docteurzoidberg/raidmaster-403/README.md

# Raidmaster 403

Tripmaster GPS de rallye-raid fait maison pour une **Peugeot 403 break Familiale de 1961**, pensé pour le raid
**Crazy Dust 2027** et utilisable au quotidien en mode balade. Boîtier autonome aimanté sur la tôle du
tableau de bord : distances partielles A et B, odomètre, vitesse, cap, moyenne, chrono.

Site du projet : **<https://docteurzoidberg.github.io/raidmaster-403/>** (présentation, maquette 3D, simulateur
dans le navigateur, manuel d'utilisation en cours de rédaction).

<p align="center">
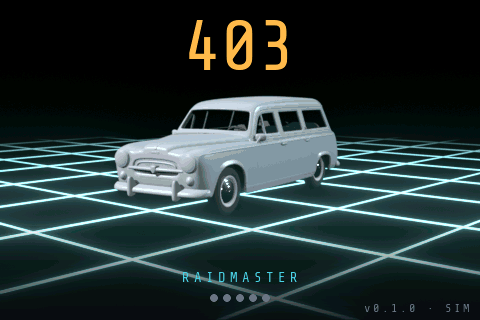
[picture p1: docs/demo/raidmaster-demo.gif]
Démo de l'interface dans le simulateur : démarrage animé, écran raid, balade, menu, calibration, mode nuit
  
</p>

<p align="center"><sub>Simulateur PC, échelle 1:1 de l'écran 480 × 320. GIF régénéré automatiquement à chaque build qui change l'interface.</sub></p>

## Matériel

| Élément | Choix |
|---|---|
| Carte | [Waveshare ESP32-S3-Touch-LCD-3.5B](https://www.waveshare.com/wiki/ESP32-S3-Touch-LCD-3.5B) : ESP32-S3, 8 Mo PSRAM, 16 Mo flash |
| Écran | 3,5" IPS 480 × 320, AXS15231B en QSPI, tactile capacitif intégré |
| GPS | au choix au montage : u-blox NEO-M9N sur la carte fille (UART, 10 Hz) + antenne active déportée sous le pare-brise, ou module externe NEO-M8N + boussole (« puck » de drone) posé sur le tableau de bord |
| Cap | magnétomètre QMC5883L (I²C) |
| Alimentation | batterie Li-ion interne gérée par l'AXP2101, recharge USB-C, aucun fil 12 V |
| Commandes | 5 boutons (A, B, menu, ▲ haut / +, ▼ bas / −) + tactile |
| Boîtier | PETG / ASA imprimé (pas de PLA : habitacle à 60 °C en été) ; fixation sur la tôle à définir (plus d'aimants noyés dans le boîtier ; des aimants rapportés au dos restent possibles) |

Distance **GPS uniquement**, sans capteur de roue ni intervention sur le câblage de la voiture.

## État

| Étape | Contenu | État |
|---|---|---|
| 1 | Squelette CMake + simulateur SDL 480 × 320 | fait |
| 2 | Core portable + tests : `gps_parser` (NMEA, sur minmea), `trip_engine` (distance, moyenne, chrono, calibration), `app` (boutons, menu, sauvegarde) | fait |
| 3 | Interface LVGL câblée sur le core : raid, balade, menu réglages actif, calibration auto, démarrage animé, mode nuit | fait |
| 4 | Simulateur : rejeu de traces NMEA, trajet simulé, scénarios de bout en bout | 23 scénarios en place (GPS, puck débranché, calibration de la boussole) ; simulateur web dans le navigateur (WebAssembly, maquette 3D et carte) ; inclinomètre et matériel à venir |
| 5-6 | HAL ESP32 et firmware sur la carte | en cours : firmware de démo validé sur la carte (écran, tactile, core et UI du sim, trajet GPS simulé, NVS, heure de la RTC, état USB / batterie), jingle de démarrage par le codec ES8311 (à écouter sur la carte) ; pilote du récepteur GPS réel écrit (NEO-M9N ou puck NEO-M8N sur UART : débit trouvé, modèle reconnu, réglé à 10 Hz) et de sa boussole (QMC5883L, IST8310, HMC5883L ou LIS3MDL sur I²C, cap dans le journal), à essayer sur la carte ; cap à l'écran, boutons, charge de la batterie à venir |
| 7-13 | Essai en modules, carte fille 4 couches (GPS, magnétomètre), boîtier aimanté, essai raid | à faire ; carte 3.5B reçue, datasheets et modèle 3D rassemblés ; PCB placé, non routé (version 1.1 : GPS interne ou puck externe) ; maquette 3D des cartes dans un boîtier de principe validée ([en ligne](https://docteurzoidberg.github.io/raidmaster-403/mockup/)) ; boîtier dessiné dans Fusion, STEP des pièces dans `enclosure/stepfiles/`, à éprouver |

Pas encore là : compensation d'inclinaison de la boussole, réglages de charge de la batterie (l'état
USB / batterie est lu, pas configuré), température réelle, log GPX.

## Maquette 3D

Les trois cartes (Waveshare, carte fille GPS et magnétomètre, carte boutons) dans leur boîtier (aspect
retenu : cannelures, pare-chocs en TPU, liseré et lettrage), assemblé ou éclaté, à faire tourner dans le navigateur : **<https://docteurzoidberg.github.io/raidmaster-403/mockup/>**. Sources de la page
dans [`web/mockup/`](web/mockup/) ; modèles 3D externes et fichiers STEP du boîtier dessiné dans Fusion (pièces
à éprouver) dans [`enclosure/`](enclosure/README.md).

<p align="center">
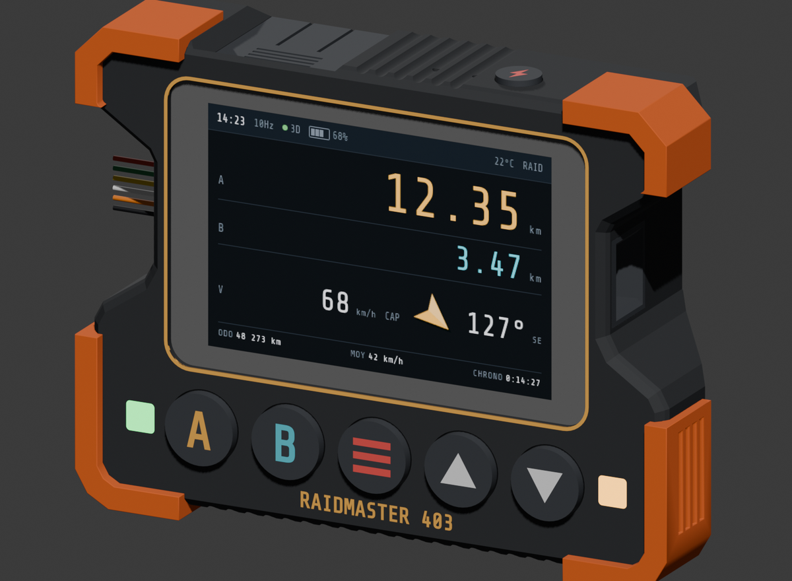
[picture p2: docs/demo/boitier-assemble.png]
Boîtier assemblé : écran 3,5 pouces, cinq boutons, deux voyants, pare-chocs en TPU orange aux coins
  
</p>
<p align="center">
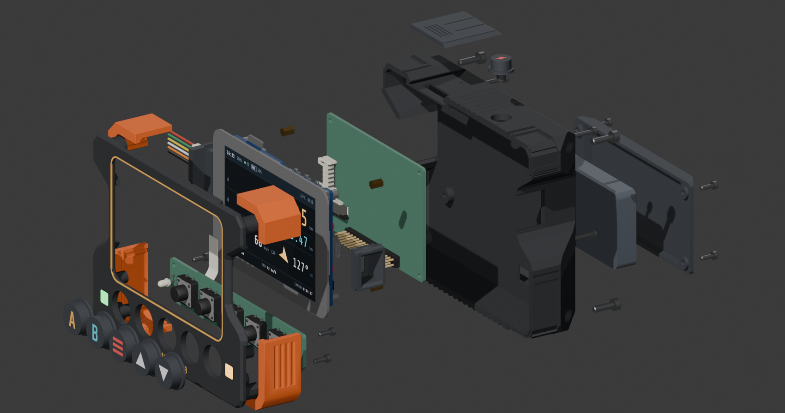
[picture p3: docs/demo/boitier-eclate.png]
Vue éclatée : capuchons, façade, pare-chocs en TPU, carte boutons et sa nappe, carte Waveshare, carte fille, fond du boîtier, batterie et sa trappe
  
</p>

<p align="center"><sub>Rendus Blender de la maquette : boîtier de 123 × 94 × 33 mm avec l'aspect retenu, esquisse du modèle dessiné pour l'impression.</sub></p>

## Simulateur dans le navigateur

Le firmware (mêmes `core/` et `ui/`, compilés en WebAssembly) tourne dans la maquette 3D : l'écran est
vivant, les cinq capuchons se cliquent (appui long en gardant le doigt 0,6 s), et une carte OpenStreetMap
suit le trajet GPS rejoué : **<https://docteurzoidberg.github.io/raidmaster-403/sim/>** (menu de toutes les
pages du site). Trajets : les scénarios des tests, ou un fichier NMEA à glisser sur la page
(il reste dans le navigateur) ; vitesse ×1 à ×1000 ; la case « Jouer les actions et les vérifications »
rejoue les appuis du scénario et affiche ses vérifications en vert ou rouge. Trips et réglages restent dans
le navigateur (bouton « Remise à zéro »). Son coupé par défaut (bouton « Son »). Mêmes touches que le
simulateur PC. Le tripmaster s'affiche de face (bouton « Recentrer » après une rotation) ; le bouton « Écran
seul » montre l'écran sur toute la largeur, avec une barre des cinq boutons dessous (`?vue=2d` l'ouvre
directement). Sur la carte, « Centrer » garde le véhicule au centre (un glisser le coupe).

Construit en local et commité dans `web/sim/` (publié avec le site). Prérequis :
[emsdk](https://emscripten.org/docs/getting_started/downloads.html) installé dans `~/sdk/emsdk` (ou
`EMSDK_DIR`), Node (celui d'emsdk suffit).

```bash
cd software
tools/web.sh             # build (build-web/), test sous Node, copie dans web/sim/
tools/web.sh serve       # sert le site web/ : http://localhost:8000/ (accueil), …/sim/
```

`tools/web.sh build`, `test` et `copy` font chaque étape seule. Le test joue les 23 scénarios dans le
module WebAssembly avec leurs vérifications, et compare une capture de l'écran à celle du simulateur PC
(identique au pixel près).

## Cartes électroniques

Deux circuits fabriqués d'un seul tenant puis séparés : la **carte fille** (78 × 54 mm, 4 couches), enfichée
au dos de la Waveshare, existe en deux variantes choisies au soudage : **GPS interne** (NEO-M9N, prise
d'antenne U.FL et boussole) ou **puck externe** (prise JST-PH 6 broches au bord gauche, protection et tampon
I²C pour le branchement à chaud) ; la **carte boutons**
(108 × 20 mm), vissée derrière la façade, porte les 5 poussoirs, les 2 voyants et deux expandeurs I²C, et
rejoint la carte fille par une nappe souple de 6 voies. Tout se soude au fer.

<p align="center">
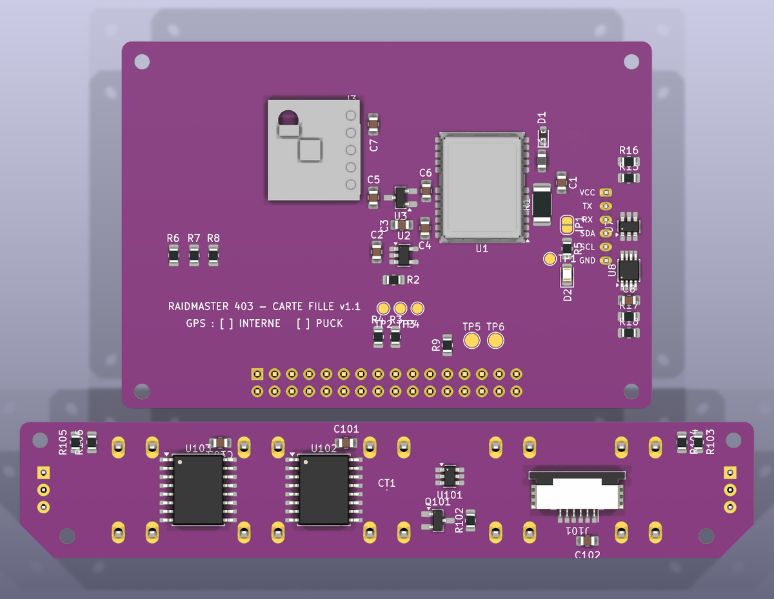
[picture p4: docs/demo/pcb-dessus.png]
Les deux cartes vues de dessus : GPS, boussole, régulateurs et protection de la prise du puck sur la carte fille ; expandeurs et connecteur de nappe au dos de la carte boutons
  
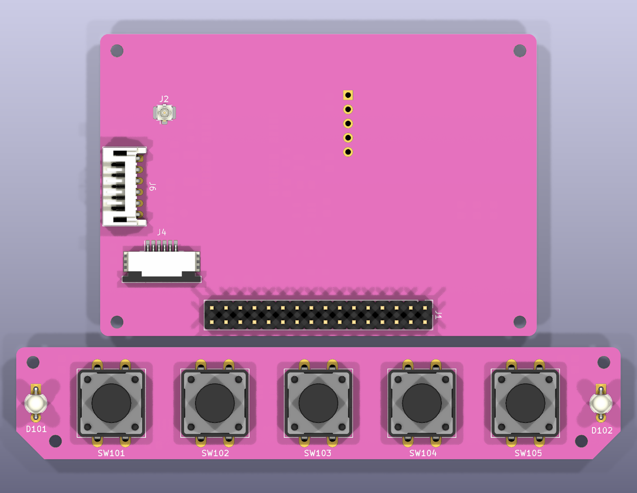
[picture p5: docs/demo/pcb-dessous.png]
Les deux cartes vues de dessous : connecteur 2 × 16 vers la Waveshare, connecteur de nappe, prise JST-PH du puck et prise d'antenne U.FL sur la carte fille ; poussoirs et voyants de la carte boutons
  
</p>

<p align="center"><sub>Rendus du visualiseur 3D de KiCad, dessus (côté batterie) et dessous (côté écran) : composants placés, routage à venir.</sub></p>

## Démarrage rapide (simulateur PC)

Prérequis : CMake ≥ 3.20, Ninja, un compilateur C11, SDL2 (`sudo apt install libsdl2-dev` sous
Debian / Ubuntu / WSL). LVGL, Unity et les autres dépendances sont téléchargées par CMake ou déjà dans le
dépôt. Le code est dans `software/` : les commandes se lancent depuis ce dossier.

```bash
cd software
cmake --preset sim
cmake --build build-sim
./build-sim/raidmaster-sim                                    # trajet simulé
./build-sim/raidmaster-sim --replay trace.nmea --speed 10     # rejoue un fichier NMEA ×10
```

Le core tourne comme sur la carte : GPS fourni par le simulateur (trajet simulé ou fichier rejoué),
réglages et distances sauvegardés dans `sim-storage.json`. Au lancement, le jingle de démarrage se joue
avec l'animation par la sortie audio SDL (WSLg sous WSL) ; `SDL_AUDIODRIVER=dummy` le coupe.

| Option | Effet |
|---|---|
| `--replay fichier.nmea` | rejoue un fichier au rythme de ses horodatages (sinon trajet simulé : boucle de 2 min) |
| `--speed N` | accélère le temps GPS, 1 à 1000 |
| `--loop` | rejoue le fichier en boucle |
| `--storage f.json` / `--no-storage` | fichier de sauvegarde (défaut `./sim-storage.json`) / en mémoire |
| `--script actions.txt --out dossier` | joue des actions horodatées en temps virtuel, sans attente (tests de bout en bout) |

| Touche | Bouton / action |
|---|---|
| `a` / `b` | A / B : RAZ Trip A / Trip B ; à la calibration auto : départ et arrivée (A), annuler (B) |
| `+` / `−` | ±10 m sur le trip actif ; dans le menu : monter / descendre, ou changer la valeur en édition |
| `m` | trip actif A ↔ B ; dans le menu : choisir / valider |
| `Maj` + touche | appui long : `Maj`+`m` entre dans le menu ou en sort, `Maj`+`+`/`−` ±100 m |
| `n` ou `Tab` | bascule jour / nuit |
| `d` | coupe / rétablit le signal GPS (tunnel) |
| `g` | débranche / rebranche le récepteur GPS (« GPS × », puis recherche du débit et réglage) |
| `c` | débranche / rebranche la boussole |
| `r` | la voiture tourne sur place / s'arrête (calibration de la boussole) |
| `p` | alimentation suivante (barre d'état) : batterie 68 %, USB en charge, USB batterie pleine, USB sans batterie, batterie 8 % |
| `v` | écran suivant (debug) |
| `Échap` | quitter (sauvegarde) |

### Tests

```bash
cd software
ctest --preset sim
tools/check.sh        # build + avertissements + tests + GIF + build firmware + simulateur web, résumé court
                      # (-c : tout recompiler, -s : sim seul, -w : sans le web)
```

- Tests unitaires du core avec [Unity](https://github.com/ThrowTheSwitch/Unity) : parseur NMEA, moteur
  de distance, application (boutons, menu, sauvegarde, source du cap), liaison avec le récepteur u-blox,
  boussole, synthétiseur et jingle de démarrage.
- Scénarios de bout en bout (`software/tests/fixtures/scenarios/`, 23 au catalogue) : le simulateur sans fenêtre
  rejoue une trace, appuie sur les boutons et vérifie l'état, en temps virtuel (une étape de 12 h se
  joue en moins d'une seconde, la suite entière en ~1,5 s). Les traces sont générées au build depuis
  l'itinéraire `route.txt` de chaque scénario (`software/tests/tools/gen_route.py`, Python sans dépendance).
- Les traces NMEA longues de `software/references/traces-brutes/` ne sont pas versionnées : présentes, elles sont
  rejouées (distances à ±0,1 % de la référence) ; absentes, ces tests sont ignorés.

### GIF de démo

`docs/demo/raidmaster-demo.gif` est régénéré par la cible CMake `demo_gif` à chaque build où le binaire du
simulateur change. Le simulateur tourne alors sans fenêtre, en temps virtuel, et enchaîne démarrage, raid,
balade, menu, calibration et raid de nuit. Le GIF se commite avec la modification d'interface qui l'a
produit.

- Désactiver : `cmake --preset sim -DRAIDMASTER_DEMO_GIF=OFF`.
- À la demande, agrandi ou vers un autre fichier : `software/tools/demo_gif.sh [-s 1..4] [-o sortie.gif]`.

### Animation de démarrage

La 403 fait un tour sur une grille cyan lumineuse, calé sur le jingle : elle s'élance sur les arpèges
puis ralentit en roue libre et s'arrête avec la fin de l'accord. L'animation est rendue dans **Blender**
(36 images en 480 × 320), puis convertie au build en `boot_anim.bin` (palette 256 couleurs) par
`ui/assets/boot_anim/build_boot_anim.py`. Deux formats, mêmes pixels, à trancher : **2** par défaut
(chaque image codée par différence avec la précédente, 0,95 Mo) ou **1** (images brutes, 5,5 Mo), choisi
par l'option CMake `RAIDMASTER_BOOT_ANIM_FORMAT`. Cette conversion demande Python avec Pillow et numpy,
désigné par la variable CMake `RAIDMASTER_PYTHON`.

La scène Blender et les images rendues ne sont pas publiées : elles reposent sur un modèle 3D de la 403
sous licence. Sans elles, ou sans Python, le build passe et l'écran de démarrage affiche une silhouette
fixe.

### Son

Le jingle de démarrage « Grille néon » (arpèges la m · fa · sol puis accord de La majeur, ~2,9 s) est
synthétisé à la volée par `core/synth.c` à partir d'une table de notes (`core/jingles.c`), en PCM 16 bits
mono à 22 050 Hz, sans fichier audio. Sortie SDL sur le sim, codec ES8311 et ampli NS4150B sur la carte
(volume dans `tools/fw.sh menuconfig`).

### Version

Le numéro de version est dans `software/VERSION` (seule source). L'écran de démarrage l'affiche avec la
plateforme : `v0.1.0 · SIM` sur le sim, `v0.1.0 · ESP32 · fe63e9e` sur la carte (hash git du firmware,
suivi de `*` s'il a été compilé avec des modifications non commitées). ESP-IDF reprend le même numéro.

### Polices

Tout l'affichage est en **Share Tech Mono**, compilée en polices bitmap LVGL, uniquement pour les tailles
et les glyphes utilisés. Les mêmes fichiers servent au simulateur et à l'ESP32. Régénération :
`ui/fonts/gen_fonts.sh` (demande Node.js, appelle `lv_font_conv`).

## Participer au projet : partir de zéro

Le développement se fait sur PC, sans la carte : simulateur et tests suffisent jusqu'à l'étape 5.
Testé sous Ubuntu 24.04 (natif ou WSL2).

1. **Outils système**

   ```bash
   sudo apt install build-essential cmake ninja-build git pkg-config libsdl2-dev python3-venv
   ```

   CMake ≥ 3.20. Sous WSL2, la fenêtre SDL s'affiche via WSLg (Windows 11).

2. **Cloner**

   ```bash
   git clone git@github.com:docteurzoidberg/raidmaster-403.git
   cd raidmaster-403
   ```

3. **Python + Pillow + numpy** (optionnel, pour l'animation de démarrage)

   ```bash
   python3 -m venv .venv
   .venv/bin/pip install pillow numpy
   ```

   CMake prend `.venv/` à la racine du dépôt (à côté de `software/`) s'il existe, sinon le `python3` du système. Pour en
   imposer un autre : `-DRAIDMASTER_PYTHON=/chemin/vers/python`. Sans Pillow ou numpy, le build passe
   quand même : le démarrage affiche une silhouette fixe.

4. **Configurer, compiler, tester, lancer**

   ```bash
   cd software
   cmake --preset sim          # télécharge LVGL et Unity au premier passage (connexion requise)
   cmake --build build-sim
   ctest --preset sim
   ./build-sim/raidmaster-sim
   ```

   Le build régénère aussi `docs/demo/raidmaster-demo.gif`. Si tu ne touches pas à l'interface et que
   `git status` le montre modifié, annule-le (`git checkout docs/demo/raidmaster-demo.gif`) ou configure
   avec `-DRAIDMASTER_DEMO_GIF=OFF`.

5. **Traces NMEA de test** (optionnel). `software/references/` n'est pas versionné. Les traces longues se
   génèrent avec les scripts Python de `software/tests/tools/` (sans dépendance, voir `software/tests/tools/README.md`),
   par exemple :

   ```bash
   mkdir -p software/references/traces-brutes
   python3 software/tests/tools/gen_nmea.py --mode linear --duration 3600 --rate 10 --speed-kmh 90 \
       --heading-deg 90 --start-lat 48.8566 --start-lon 2.3522 --start-utc 2026-10-09T06:00:00+00:00 \
       --out software/references/traces-brutes/stage_highway_1h.nmea
   ```

   Sans elles, les tests qui les rejouent sont ignorés. Si les paramètres diffèrent de ceux de
   référence, ces tests peuvent échouer sur les comptes attendus.

6. **Avant de proposer une modification**
   - Pour un changement important, ouvrir d'abord une issue pour en discuter.
   - C11 strict, compilation sans avertissement (`-Wall -Wextra -Wpedantic`), `core/` sans aucun
     accès matériel ni LVGL.
   - Une branche par sujet, `software/tools/check.sh` propre (aucun avertissement, tests verts), GIF de démo commité avec toute modification de
     l'interface, ce README mis à jour s'il devient faux.
   - Optionnel : `compile_commands.json` est exporté dans `software/build-sim/` pour clangd ou ton IDE (lien
     symbolique à la racine si besoin).
   - Code sous GPL-3.0.

## Firmware ESP32

Projet ESP-IDF dans `software/firmware/`, construit avec **ESP-IDF v5.5.6** et les **mêmes** `core/` et
`ui/` que le simulateur (leurs `CMakeLists.txt` servent aux deux builds) ; les pilotes de la carte sont
dans `software/hal_esp32/`. Version actuelle : **démo** sans périphérique externe (trajet GPS simulé,
tactile en guise de boutons, sauvegarde en NVS, animation de démarrage en flash, jingle de démarrage par
le codec ES8311, heure de la RTC, état USB / batterie lu sur le PMIC).

```bash
cd software
tools/fw.sh build        # compile (ESP-IDF chargé par le script)
tools/fw.sh flash        # programme + animation de démarrage, puis 10 s de journal de la carte
tools/fw.sh log 20       # redémarre la carte et affiche 20 s de journal
tools/fw.sh menuconfig   # menu « Raidmaster 403 » : sens de l'écran, rétroéclairage, volume, tactile-boutons, source GPS, boussole
```

Installation d'ESP-IDF, liaison de la carte à WSL (usbipd), réglages et dépannage :
[`software/firmware/README.md`](software/firmware/README.md).

## Organisation du dépôt

```
software/        tout le code ; CMakeLists.txt et CMakePresets.json, build dans software/build-sim/ ;
                 VERSION : numéro de version
  core/          logique métier en C11 portable (aucun accès matériel) : gps_parser, trip_engine, app,
                 gps_synth (trajet simulé), ubx et gps_link (liaison avec un récepteur u-blox), mag (boussole),
                 synth et jingles (son) ; core/include/hal/ : interfaces matériel ;
                 core/third_party/minmea
  ui/            interface LVGL v9 : écrans, thème jour / nuit, polices, images, animation de démarrage
  sim/           simulateur PC SDL2 : fenêtre, clavier, options, mode script (script.c), captures, GIF
  hal_sim/       HAL du simulateur : GPS (rejeu, trajet simulé), stockage JSON, horloge, assets, son SDL
  simweb/        simulateur web (WebAssembly) : front-end, index des scénarios, test Node (tests/)
  hal_simweb/    HAL du simulateur web : stockage du navigateur, son Web Audio (le reste vient de hal_sim/)
  hal_esp32/     HAL et pilotes de la carte (écran QSPI, tactile, RTC, PMIC, son ES8311, NVS, GPS de démo ou réel…),
                 composant ESP-IDF
  firmware/      projet ESP-IDF (main/, sdkconfig.defaults, partitions.csv), build dans software/build-firmware/
  cmake/         modules CMake communs au sim et au firmware (animation de démarrage, version)
  tests/         tests unitaires Unity, scénarios (fixtures/scenarios/), tools/ : outils Python NMEA
  tools/         scripts : check.sh (vérification complète), fw.sh (firmware), web.sh (simulateur web), demo_gif.sh
  references/    non versionné : traces NMEA de test
hardware/kicad/carte-fille/
                 projet KiCad 10 de la carte fille et de la carte boutons (schémas, PCB, bibliothèques,
                 3d/ : modèles 3D propres et leur provenance, export/ : STEP des deux cartes)
hardware/kicad/BOM.md
                 composants des deux cartes : version GPS intégré et version puck GPS externe
enclosure/       boîtier : modèles 3D externes utilisés (README.md), stepfiles/ : exports STEP des pièces du boîtier
web/             site publié sur GitHub Pages : accueil (index.html), common/ : en-tête et styles communs,
                 mockup/ : maquette 3D des cartes dans leur boîtier (page three.js et modèle GLB),
                 sim/ : simulateur web (page, module construit par tools/web.sh, scénarios),
                 manual/ : manuel d'utilisation (en cours de rédaction), img/ : images de l'accueil
.github/         workflow de publication de web/ sur GitHub Pages
docs/demo/       GIF de démo, rendus des cartes (KiCad) et du boîtier (Blender)
```

## Documentation

- [`software/firmware/README.md`](software/firmware/README.md) : installation d'ESP-IDF, liaison de la
  carte, réglages et dépannage du firmware.
- [`software/tests/tools/README.md`](software/tests/tools/README.md) : outils NMEA (génération, bruit,
  validation, enregistrement).
- [`software/tests/fixtures/scenarios/README.md`](software/tests/fixtures/scenarios/README.md) : catalogue
  des scénarios de bout en bout.
- [`enclosure/README.md`](enclosure/README.md) : modèles 3D externes et fichiers STEP du boîtier.
- [`web/README.md`](web/README.md) : le site ([en ligne](https://docteurzoidberg.github.io/raidmaster-403/)) :
  accueil, maquette 3D, simulateur web, manuel.

## Licence

[GPL-3.0](LICENSE).

Composants tiers :

| Composant | Licence | Usage |
|---|---|---|
| [LVGL](https://lvgl.io) v9.2.2 | MIT | interface, téléchargé au build (FetchContent pour le sim, registre ESP-IDF pour le firmware) |
| [ESP-IDF](https://github.com/espressif/esp-idf) v5.5.6 | Apache-2.0 | framework du firmware, installé à part |
| [esp_lcd_axs15231b](https://components.espressif.com/components/espressif/esp_lcd_axs15231b) 1.0.1, [esp_io_expander_tca9554](https://components.espressif.com/components/espressif/esp_io_expander_tca9554) 2.0.3 | Apache-2.0 | pilotes d'écran et d'expandeur, téléchargés au build |
| [esp_codec_dev](https://components.espressif.com/components/espressif/esp_codec_dev) 1.3.4 | Apache-2.0 | pilote du codec audio ES8311, téléchargé au build |
| Séquence d'init du panneau ([exemples Waveshare](https://github.com/waveshareteam/ESP32-S3-Touch-LCD-3.5B)) | Apache-2.0 | dans `hal_esp32/board_display.c` |
| [minmea](https://github.com/kosma/minmea) | MIT (au choix WTFPL / MIT / LGPL-3) | décodage NMEA, dans `core/third_party/minmea/` |
| [Unity](https://github.com/ThrowTheSwitch/Unity) v2.6.1 | MIT | tests, téléchargé au build |
| [Share Tech Mono](https://fonts.google.com/specimen/Share+Tech+Mono) | SIL OFL 1.1 | police, dans `ui/assets/` |
| [three.js](https://threejs.org) 0.186.1 | MIT | maquette 3D et simulateur web (`web/`), chargé depuis jsDelivr |
| [Leaflet](https://leafletjs.com) 1.9.4 | BSD-2-Clause | carte du simulateur web (`web/sim/`), chargé depuis jsDelivr |
| Tuiles [OpenStreetMap](https://www.openstreetmap.org/copyright) | données ODbL, attribution affichée | fond de carte du simulateur web, usage léger ([politique des tuiles](https://operations.osmfoundation.org/policies/tiles/)) |
| [Emscripten](https://emscripten.org) | MIT / University of Illinois NCSA | compilateur du simulateur web, installé à part ; son code d'exécution est dans le module construit |
