docteurzoidberg/raidmaster-403/enclosure/stepfiles/README.md

# Fichiers STEP du boîtier

Exports STEP des pièces du boîtier du Raidmaster 403, depuis le modèle Fusion. Toutes les pièces sont dans le
même repère et s'assemblent sans déplacement.

La liste des fichiers et leur contenu sont dans [`../README.md`](../README.md) (section « Fichiers STEP du
projet »).
