docteurzoidberg/raidmaster-403/enclosure/stepfiles/manchon_bouchon.step

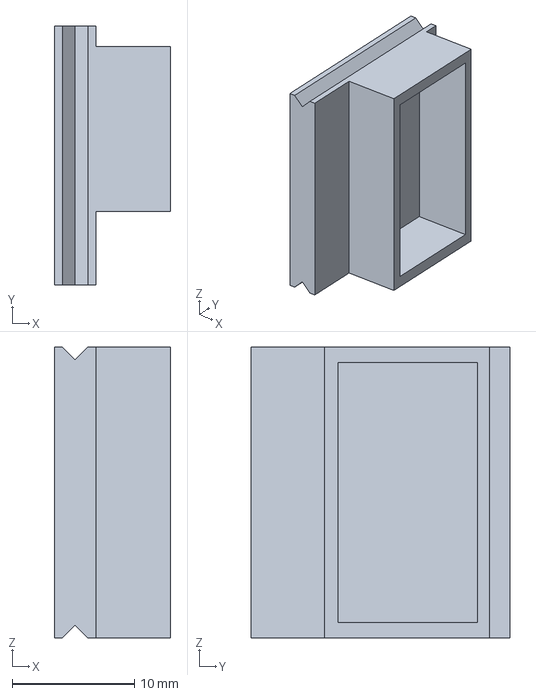
[picture p6: CAD file, 2026-11-14]
enclosure/stepfiles/manchon_bouchon.step
9.50 x 21.1 x 23.8 mm
