docteurzoidberg/raidmaster-403/hardware/kicad/carte-fille/3d/GY-271_module.step

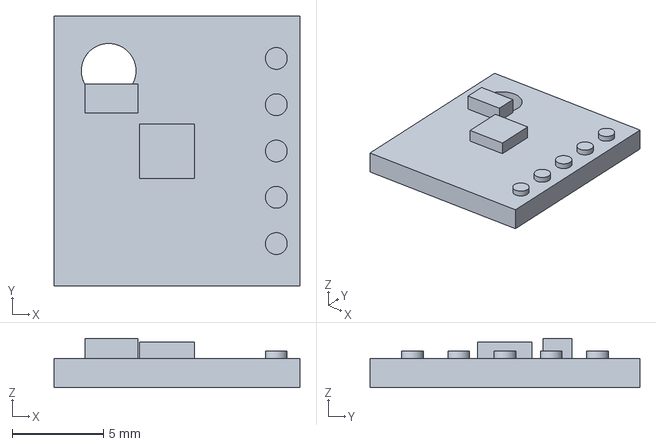
[picture p7: CAD file, 2026-11-11]
hardware/kicad/carte-fille/3d/GY-271_module.step
13.5 x 14.8 x 2.70 mm
