docteurzoidberg/raidmaster-403/hardware/kicad/carte-fille/export/carte-boutons.step

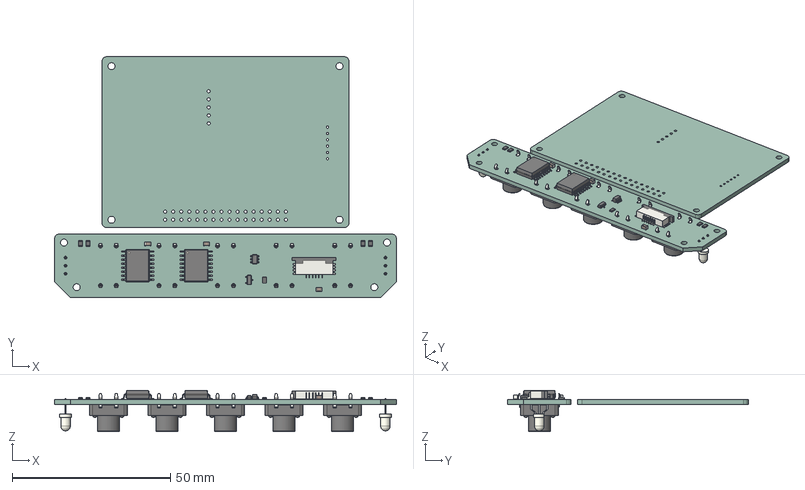
[picture p8: CAD file, 2026-11-12]
hardware/kicad/carte-fille/export/carte-boutons.step
108.0 x 76.0 x 13.0 mm
SOIC-16W_7.5x10.3mm_P1.27mm x 2
TE_84952_6
C_0805_2012Metric x 3
R_0805_2012Metric x 5
SOT-23
SOT-23-6
LED_D3.0mm-3 x 2
SW_PUSH-12mm_Wuerth-430476085716 x 5
carte-fille_PCB_1
carte-fille_PCB_2
