docteurzoidberg/raidmaster-403/enclosure/stepfiles/coque_arriere.step

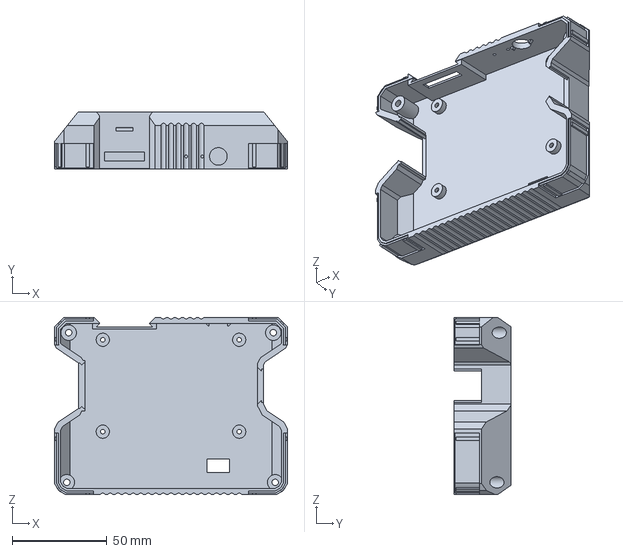
[picture p9: CAD file, 2026-11-14]
enclosure/stepfiles/coque_arriere.step
123.0 x 30.2 x 93.6 mm
