docteurzoidberg/raidmaster-403/hardware/kicad/carte-fille/3d/ublox_NEO.step

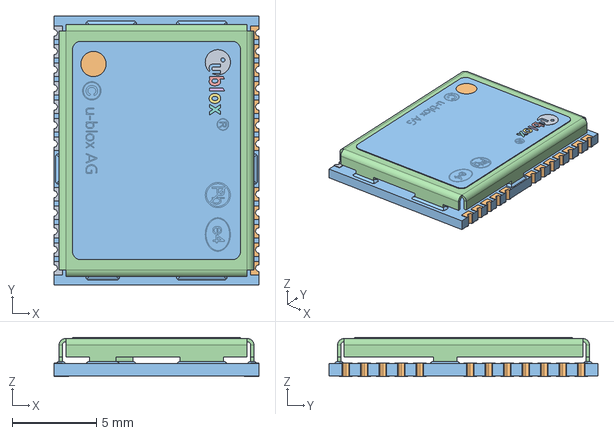
[picture p10: CAD file, 2026-10-24]
hardware/kicad/carte-fille/3d/ublox_NEO.step
12.2 x 16.0 x 2.33 mm
