docteurzoidberg/raidmaster-403/enclosure/stepfiles/facade.step

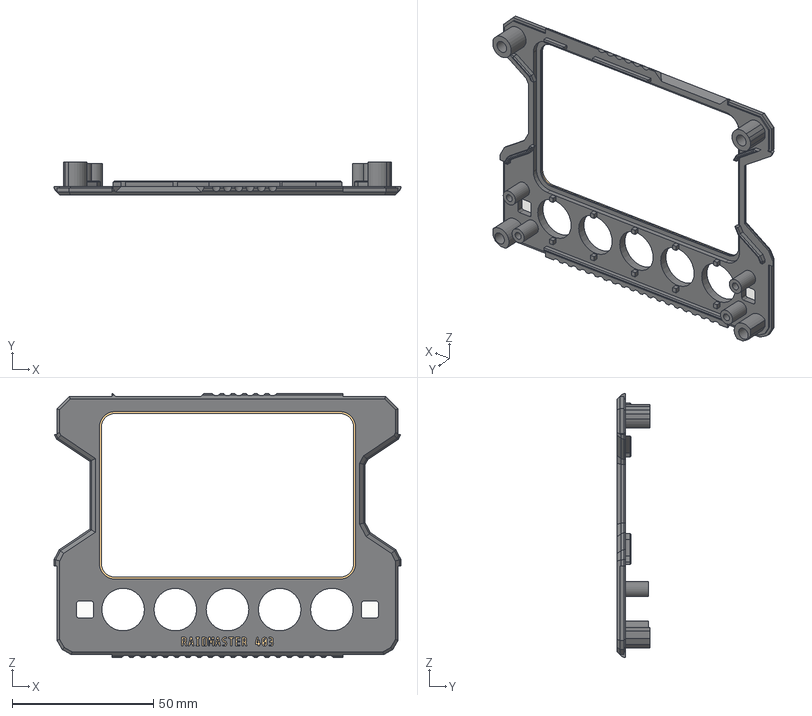
[picture p11: CAD file, 2026-11-14]
enclosure/stepfiles/facade.step
123.0 x 11.6 x 93.6 mm
