docteurzoidberg/raidmaster-403/enclosure/stepfiles/manchon_puck.step

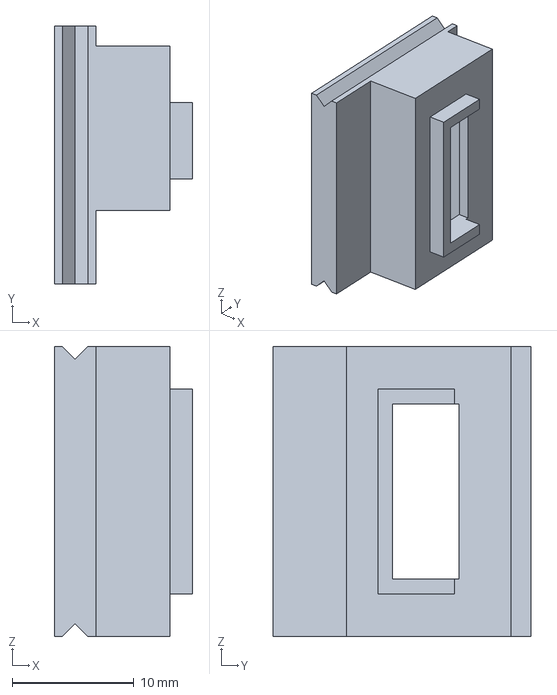
[picture p12: CAD file, 2026-11-14]
enclosure/stepfiles/manchon_puck.step
11.3 x 21.1 x 23.8 mm
