docteurzoidberg/raidmaster-403/enclosure/stepfiles/manchon_usb.step

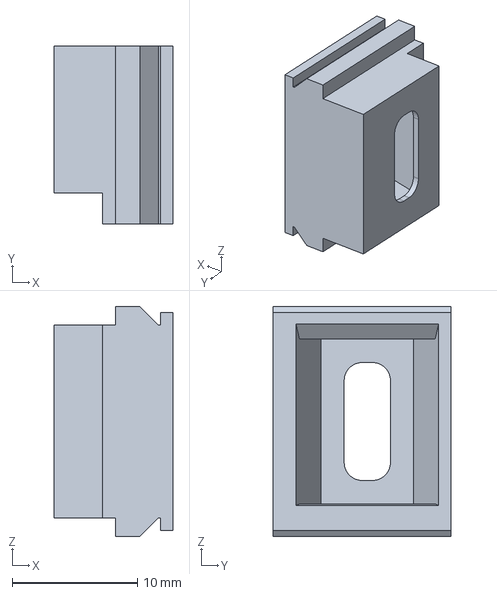
[picture p13: CAD file, 2026-11-14]
enclosure/stepfiles/manchon_usb.step
9.50 x 14.2 x 18.4 mm
