docteurzoidberg/raidmaster-403/enclosure/stepfiles/poussoir_pwr.step

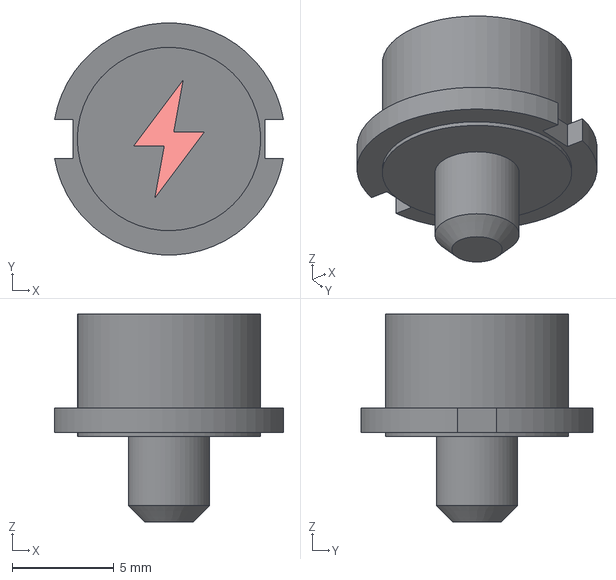
[picture p14: CAD file, 2026-11-14]
enclosure/stepfiles/poussoir_pwr.step
11.2 x 11.4 x 10.2 mm
