docteurzoidberg/raidmaster-403/enclosure/stepfiles/capuchon_bas.step

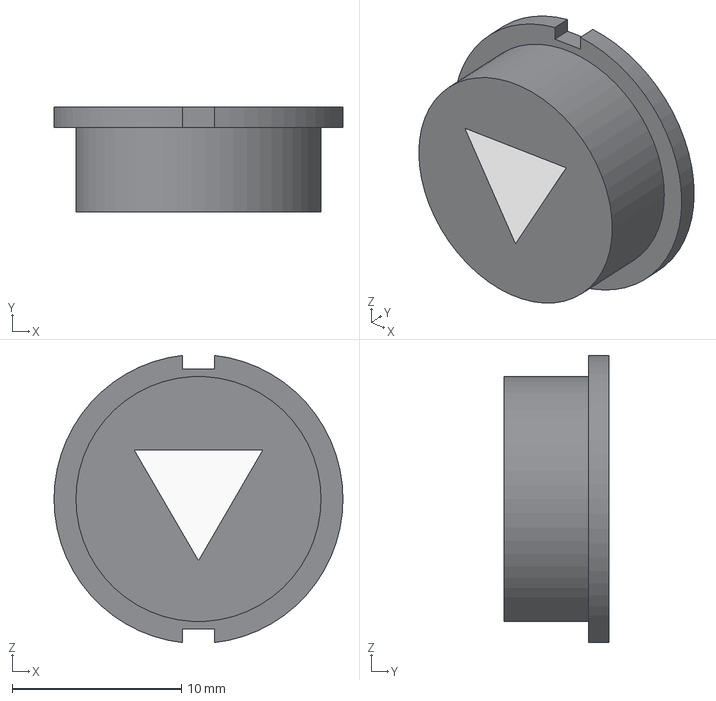
[picture p16: CAD file, 2026-11-13]
enclosure/stepfiles/capuchon_bas.step
17.1 x 6.20 x 17.0 mm
