docteurzoidberg/raidmaster-403/enclosure/stepfiles/pare_chocs.step

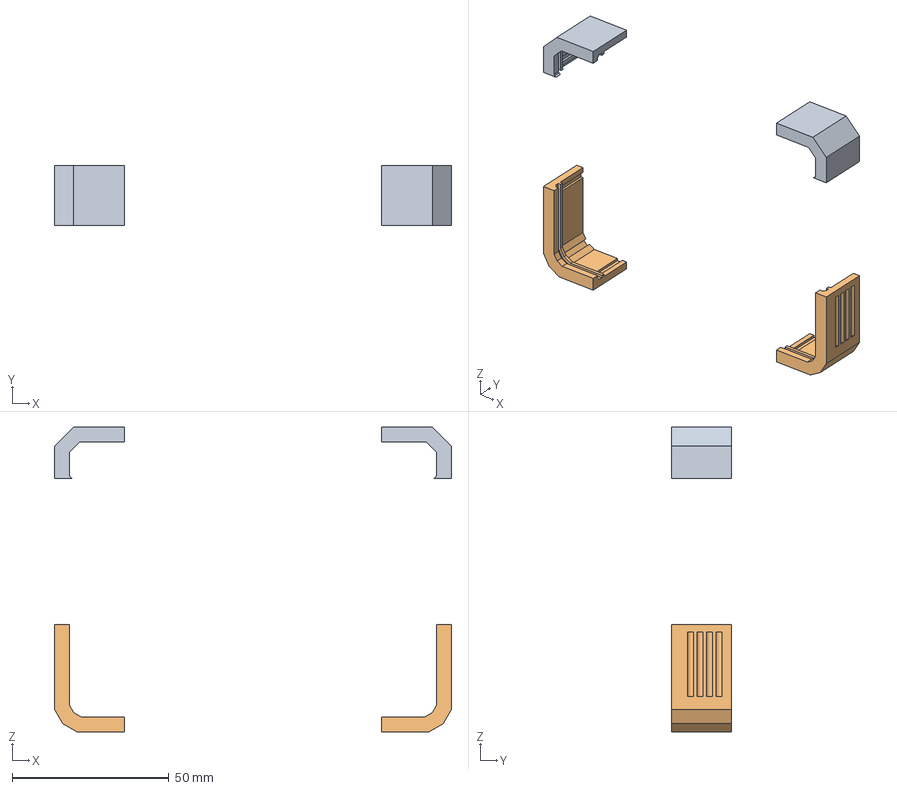
[picture p18: CAD file, 2026-11-13]
enclosure/stepfiles/pare_chocs.step
126.6 x 19.1 x 97.2 mm
