docteurzoidberg/raidmaster-403/enclosure/stepfiles/trappe_batterie.step

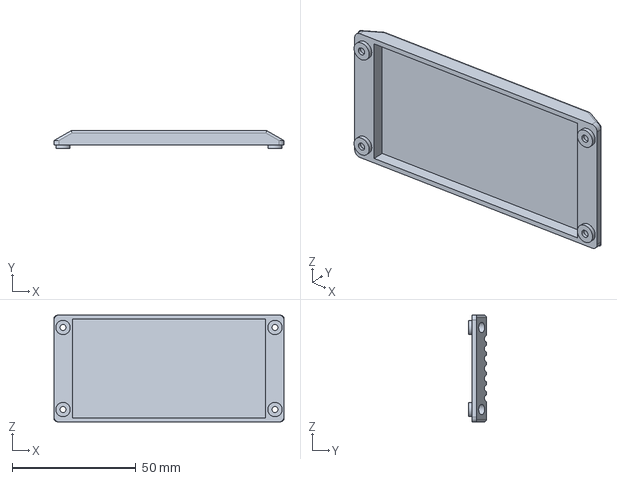
[picture p19: CAD file, 2026-11-13]
enclosure/stepfiles/trappe_batterie.step
93.0 x 7.20 x 43.2 mm
