docteurzoidberg/raidmaster-403/enclosure/stepfiles/trappe_sd.step

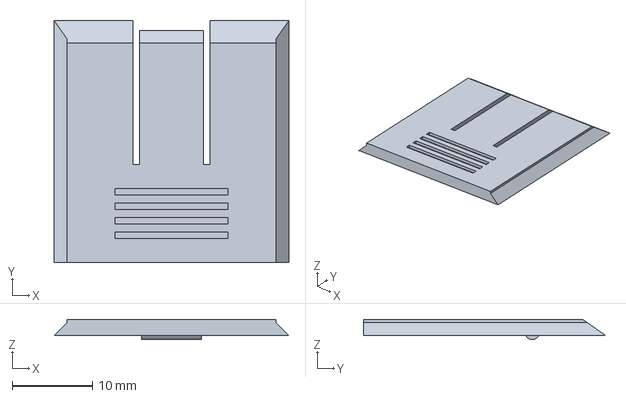
[picture p20: CAD file, 2026-11-12]
enclosure/stepfiles/trappe_sd.step
29.2 x 30.1 x 2.50 mm
