docteurzoidberg/raidmaster-403/(list of files, cad)

Other CAD files:
hardware/kicad/carte-fille/export/carte-fille.step
enclosure/stepfiles/manchon_antenne.step
enclosure/stepfiles/capuchon_haut.step
enclosure/stepfiles/capuchon_A.step
