docteurzoidberg/raidmaster-403/hardware/kicad/carte-fille/carte-fille.kicad_pcb

## KiCad design hardware/kicad/carte-fille/carte-fille.kicad_pcb (2026-11-12)

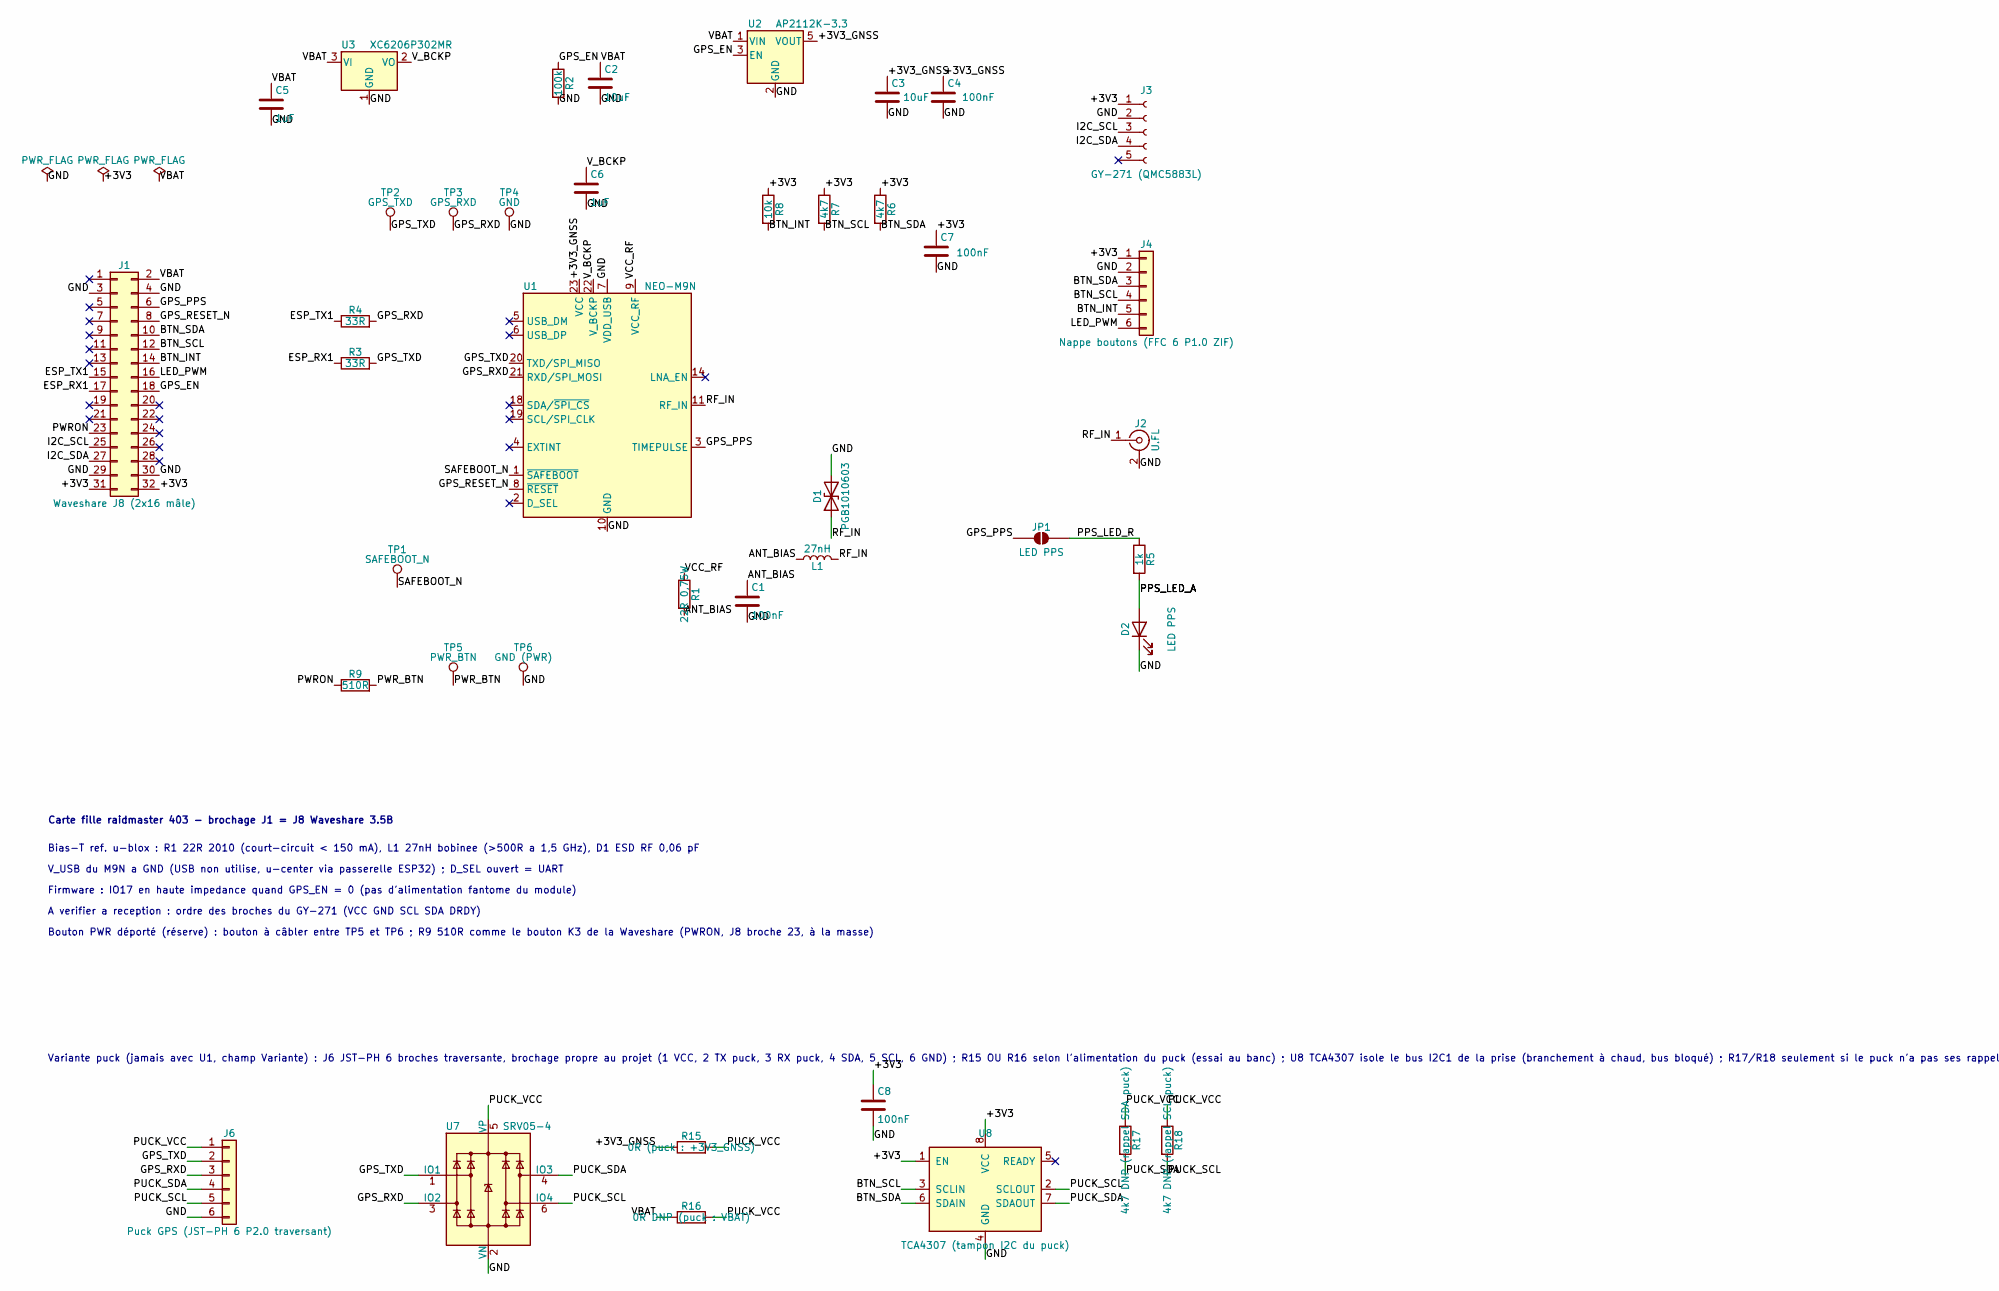
[picture p21: schematic carte-fille.kicad_sch, Raidmaster 403 - carte fille, part in row 1, column 1]

Parts:
C1, C4, C7, C8: 100nF; C_0805_2012Metric_Pad1.18x1.45mm_HandSolder
C2, C3: 10uF; C_0805_2012Metric_Pad1.18x1.45mm_HandSolder
C5, C6: 1uF; C_0805_2012Metric_Pad1.18x1.45mm_HandSolder
D1: PGB1010603; D_0603_1608Metric_Pad1.05x0.95mm_HandSolder
D2: LED PPS; LED_0805_2012Metric_Pad1.15x1.40mm_HandSolder
J1: Waveshare J8 (2x16 mâle); PinHeader_2x16_P2.54mm_Vertical
J2: U.FL; U.FL_Hirose_U.FL-R-SMT-1_Vertical
J3: GY-271 (QMC5883L); PinHeader_1x05_P2.54mm_Vertical
J4: Nappe boutons (FFC 6 P1.0 ZIF); TE_84952-6_1x06-1MP_P1.0mm_Horizontal
J6: Puck GPS (JST-PH 6 P2.0 traversant); JST_PH_S6B-PH-K_1x06_P2.00mm_Horizontal
JP1: LED PPS; SolderJumper-2_P1.3mm_Open_RoundedPad1.0x1.5mm
L1: 27nH; L_0805_2012Metric_Pad1.05x1.20mm_HandSolder
R1: 22R 0,75W; R_2010_5025Metric_Pad1.40x2.65mm_HandSolder
R2: 100k; R_0805_2012Metric_Pad1.20x1.40mm_HandSolder
R3, R4: 33R; R_0805_2012Metric_Pad1.20x1.40mm_HandSolder
R5: 1k; R_0805_2012Metric_Pad1.20x1.40mm_HandSolder
R6, R7: 4k7; R_0805_2012Metric_Pad1.20x1.40mm_HandSolder
R8: 10k; R_0805_2012Metric_Pad1.20x1.40mm_HandSolder
R9: 510R; R_0805_2012Metric_Pad1.20x1.40mm_HandSolder
R15: 0R (puck : +3V3_GNSS); R_0805_2012Metric_Pad1.20x1.40mm_HandSolder
R16: 0R DNP (puck : VBAT); R_0805_2012Metric_Pad1.20x1.40mm_HandSolder
R17: 4k7 DNP (rappel SDA puck); R_0805_2012Metric_Pad1.20x1.40mm_HandSolder
R18: 4k7 DNP (rappel SCL puck); R_0805_2012Metric_Pad1.20x1.40mm_HandSolder
TP1: SAFEBOOT_N; TestPoint_Pad_D1.5mm
TP2: GPS_TXD; TestPoint_Pad_D1.5mm
TP3: GPS_RXD; TestPoint_Pad_D1.5mm
TP4: GND; TestPoint_Pad_D1.5mm
TP5: PWR_BTN; TestPoint_Pad_D2.0mm
TP6: GND (PWR); TestPoint_Pad_D2.0mm
U1: NEO-M9N; ublox_NEO
U2: AP2112K-3.3; SOT-23-5_HandSoldering
U3: XC6206P302MR; SOT-23_Handsoldering
U7: SRV05-4; SOT-23-6_Handsoldering
U8: TCA4307 (tampon I2C du puck); VSSOP-8_3x3mm_P0.65mm

Connections:
/+3V3: C7.1, C8.1, J1.31, J1.32, J3.1, J4.1, R6.1, R7.1, R8.1, U8.1 (EN), U8.8 (VCC)
/+3V3_GNSS: C3.1, C4.1, R15.1, U1.23 (VCC), U2.5 (VOUT)
/ANT_BIAS: C1.1, L1.1, R1.2
/BTN_INT: J1.14, J4.5, R8.2
/BTN_SCL: J1.12, J4.4, R7.2, U8.3 (SCLIN)
/BTN_SDA: J1.10, J4.3, R6.2, U8.6 (SDAIN)
/ESP_RX1: J1.17, R3.1
/ESP_TX1: J1.15, R4.1
/GND: C1.2, C2.2, C3.2, C4.2, C5.2, C6.2, C7.2, C8.2, D1.2 (A2), D2.1 (K), J1.3, J1.4, J1.29, J1.30, J2.2 (Ext), J3.2, J4.2, J6.6, R2.2, TP4.1 (1_1), TP6.1 (1_1), U1.7 (VDD_USB), U1.10 (GND), U1.12 (GND), U1.13 (GND), U1.24 (GND), U2.2 (GND), U3.1 (GND), U7.2 (VN), U8.4 (GND)
/GPS_EN: J1.18, R2.1, U2.3 (EN)
/GPS_PPS: J1.6, JP1.1 (A), U1.3 (TIMEPULSE)
/GPS_RESET_N: J1.8, U1.8 (~RESET)
/GPS_RXD: J6.3, R4.2, TP3.1 (1_1), U1.21 (RXD/SPI_MOSI), U7.3 (IO2)
/GPS_TXD: J6.2, R3.2, TP2.1 (1_1), U1.20 (TXD/SPI_MISO), U7.1 (IO1)
/I2C_SCL: J1.25, J3.3
/I2C_SDA: J1.27, J3.4
/LED_PWM: J1.16, J4.6
/PPS_LED_A: D2.2 (A), R5.2
/PPS_LED_R: JP1.2 (B), R5.1
/PUCK_SCL: J6.5, R18.2, U7.6 (IO4), U8.2 (SCLOUT)
/PUCK_SDA: J6.4, R17.2, U7.4 (IO3), U8.7 (SDAOUT)
/PUCK_VCC: J6.1, R15.2, R16.2, R17.1, R18.1, U7.5 (VP)
/PWRON: J1.23, R9.1
/PWR_BTN: R9.2, TP5.1 (1_1)
/RF_IN: D1.1 (A1), J2.1 (In), L1.2, U1.11 (RF_IN)
/SAFEBOOT_N: TP1.1 (1_1), U1.1 (~SAFEBOOT)
/VBAT: C2.1, C5.1, J1.2, R16.1, U2.1 (VIN), U3.3 (VI)
/VCC_RF: R1.1, U1.9 (VCC_RF)
/V_BCKP: C6.1, U1.22 (V_BCKP), U3.2 (VO)

Notes on the sheet:
Bouton PWR déporté (réserve) : bouton à câbler entre TP5 et TP6 ; R9 510R comme le bouton K3 de la Waveshare (PWRON, J8 broche 23, à la masse)
V_USB du M9N a GND (USB non utilise, u-center via passerelle ESP32) ; D_SEL ouvert = UART
A verifier a reception : ordre des broches du GY-271 (VCC GND SCL SDA DRDY)
Carte fille raidmaster 403 - brochage J1 = J8 Waveshare 3.5B
2 × PCF8574T sur bus I2C1 dédié (100 kHz max) : U102 = boutons, 0x20, P0-P4 = BTN1-BTN5, INT ; U103 = LED, 0x21, P0-P3 = cathodes ; P5-P7 / P4-P7 en réserve
A verifier a reception : brochage KAK (anode au milieu) et couleur de K1 / K2 des LED bicolores
Bias-T ref. u-blox : R1 22R 2010 (court-circuit < 150 mA), L1 27nH bobinee (>500R a 1,5 GHz), D1 ESD RF 0,06 pF
LED_PWM actif bas (P-MOSFET Q101) : PWM IO42 = luminosité globale ; sortie de U103 à 0 = couleur allumée (cathode tirée à la masse)
Partie détachable (mouse bites) : nets F_* séparés de la carte fille, reliés seulement par la nappe FFC 6 voies
Variante puck (jamais avec U1, champ Variante) : J6 JST-PH 6 broches traversante, brochage propre au projet (1 VCC, 2 TX puck, 3 RX puck, 4 SDA, 5 SCL, 6 GND) ; R15 OU R16 selon l'alimentation du puck (essai au banc) ; U8 TCA4307 isole le bus I2C1 de la prise (branchement à chaud, bus bloqué) ; R17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
Firmware : IO17 en haute impedance quand GPS_EN = 0 (pas d'alimentation fantome du module)

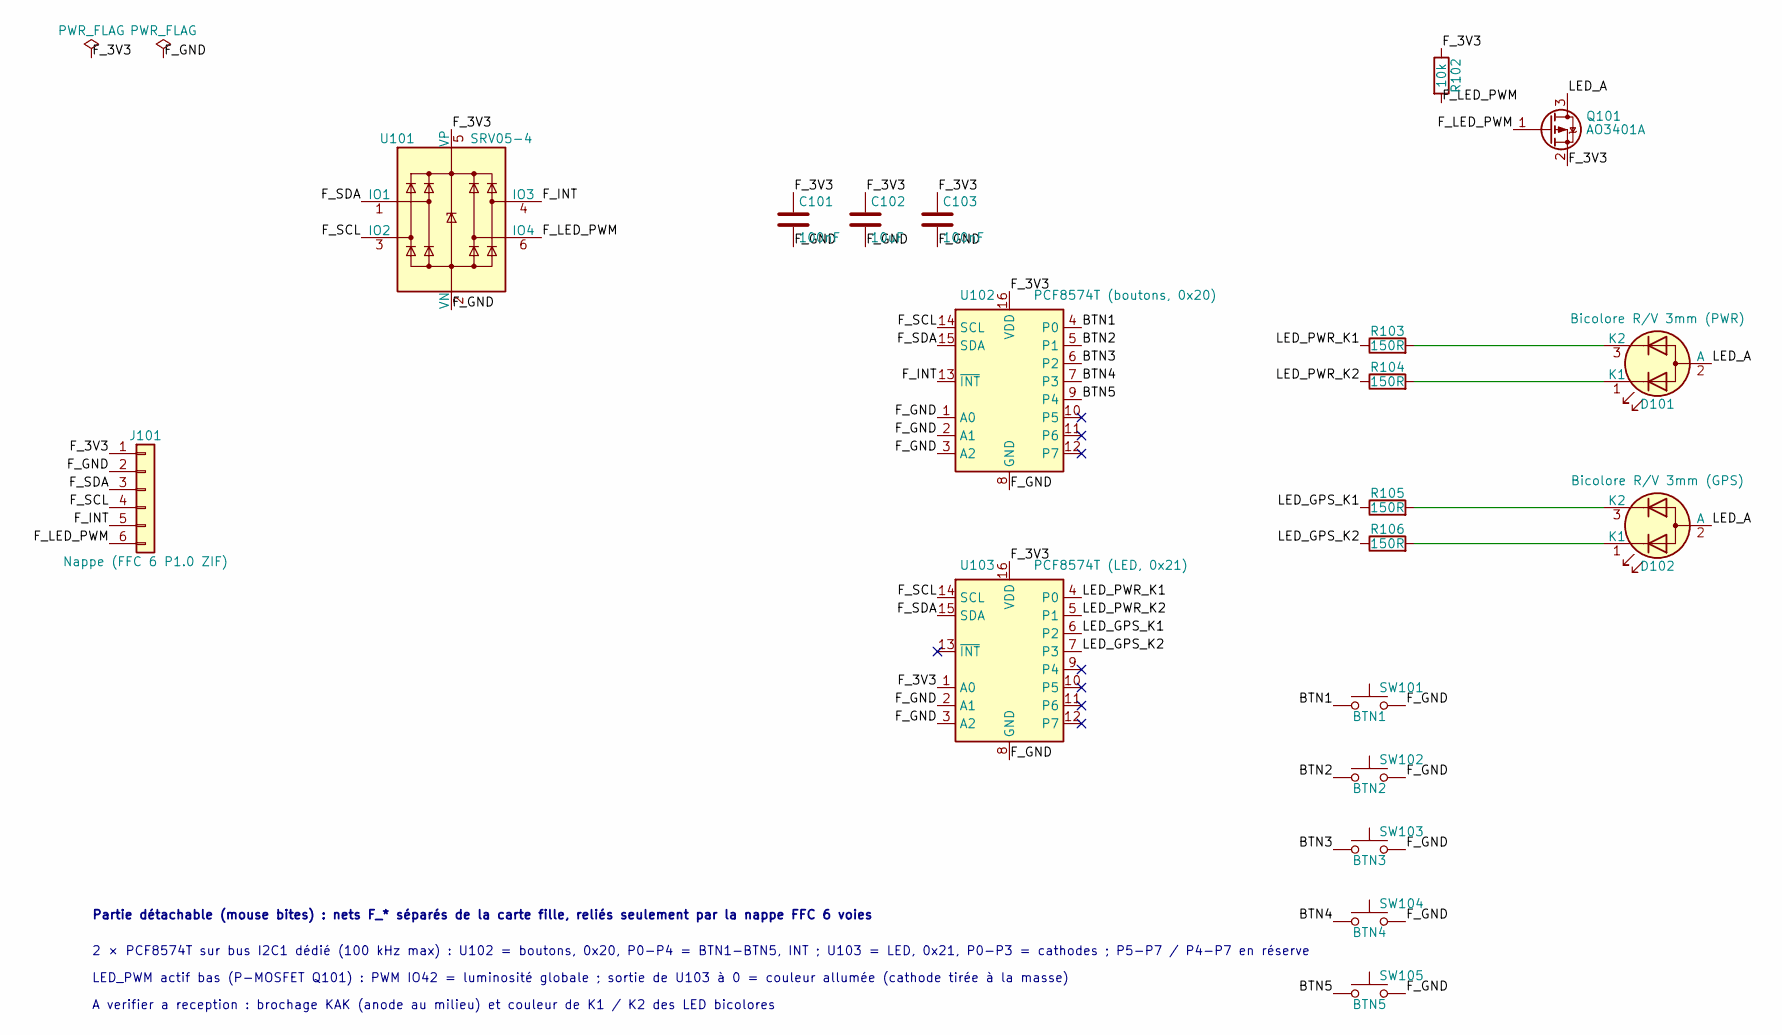
[picture p22: schematic carte-boutons.kicad_sch, Raidmaster 403 - carte boutons]

Parts:
C101, C103: 100nF; C_0805_2012Metric_Pad1.18x1.45mm_HandSolder
C102: 10uF; C_0805_2012Metric_Pad1.18x1.45mm_HandSolder
D101: Bicolore R/V 3mm (PWR); LED_D3.0mm-3
D102: Bicolore R/V 3mm (GPS); LED_D3.0mm-3
J101: Nappe (FFC 6 P1.0 ZIF); TE_84952-6_1x06-1MP_P1.0mm_Horizontal
Q101: AO3401A; SOT-23_Handsoldering
R102: 10k; R_0805_2012Metric_Pad1.20x1.40mm_HandSolder
R103, R104, R105, R106: 150R; R_0805_2012Metric_Pad1.20x1.40mm_HandSolder
SW101: BTN1; SW_PUSH-12mm
SW102: BTN2; SW_PUSH-12mm
SW103: BTN3; SW_PUSH-12mm
SW104: BTN4; SW_PUSH-12mm
SW105: BTN5; SW_PUSH-12mm
U101: SRV05-4; SOT-23-6_Handsoldering
U102: PCF8574T (boutons, 0x20); SOIC-16W_7.5x10.3mm_P1.27mm
U103: PCF8574T (LED, 0x21); SOIC-16W_7.5x10.3mm_P1.27mm

Connections:
/carte-boutons (partie détachable)/BTN1: SW101.1, U102.4 (P0)
/carte-boutons (partie détachable)/BTN2: SW102.1, U102.5 (P1)
/carte-boutons (partie détachable)/BTN3: SW103.1, U102.6 (P2)
/carte-boutons (partie détachable)/BTN4: SW104.1, U102.7 (P3)
/carte-boutons (partie détachable)/BTN5: SW105.1, U102.9 (P4)
/carte-boutons (partie détachable)/F_3V3: C101.1, C102.1, C103.1, J101.1, Q101.2 (S), R102.1, U101.5 (VP), U102.16 (VDD), U103.1 (A0), U103.16 (VDD)
/carte-boutons (partie détachable)/F_GND: C101.2, C102.2, C103.2, J101.2, SW101.2, SW102.2, SW103.2, SW104.2, SW105.2, U101.2 (VN), U102.1 (A0), U102.2 (A1), U102.3 (A2), U102.8 (GND), U103.2 (A1), U103.3 (A2), U103.8 (GND)
/carte-boutons (partie détachable)/F_INT: J101.5, U101.4 (IO3), U102.13 (~INT)
/carte-boutons (partie détachable)/F_LED_PWM: J101.6, Q101.1 (G), R102.2, U101.6 (IO4)
/carte-boutons (partie détachable)/F_SCL: J101.4, U101.3 (IO2), U102.14 (SCL), U103.14 (SCL)
/carte-boutons (partie détachable)/F_SDA: J101.3, U101.1 (IO1), U102.15 (SDA), U103.15 (SDA)
/carte-boutons (partie détachable)/LED_A: D101.2 (A), D102.2 (A), Q101.3 (D)
/carte-boutons (partie détachable)/LED_GPS_K1: R105.1, U103.6 (P2)
/carte-boutons (partie détachable)/LED_GPS_K2: R106.1, U103.7 (P3)
/carte-boutons (partie détachable)/LED_PWR_K1: R103.1, U103.4 (P0)
/carte-boutons (partie détachable)/LED_PWR_K2: R104.1, U103.5 (P1)
unnamed: D101.1 (K1), R104.2
unnamed: D101.3 (K2), R103.2
unnamed: D102.1 (K1), R106.2
unnamed: D102.3 (K2), R105.2

Notes on the sheet:
LED_PWM actif bas (P-MOSFET Q101) : PWM IO42 = luminosité globale ; sortie de U103 à 0 = couleur allumée (cathode tirée à la masse)
Partie détachable (mouse bites) : nets F_* séparés de la carte fille, reliés seulement par la nappe FFC 6 voies
2 × PCF8574T sur bus I2C1 dédié (100 kHz max) : U102 = boutons, 0x20, P0-P4 = BTN1-BTN5, INT ; U103 = LED, 0x21, P0-P3 = cathodes ; P5-P7 / P4-P7 en réserve
A verifier a reception : brochage KAK (anode au milieu) et couleur de K1 / K2 des LED bicolores

Board: 4 copper layers, 70 parts (11 on the bottom side), 49 nets, no tracks yet.

Other parts of the board:
CT1: Contour_carte_boutons
H1, H2, H3, H4, H5, H6, H7, H8: MountingHole_2.2mm_M2
