docteurzoidberg/raidmaster-403/software/ui/img_cap_arrow.c

/*
 * Raidmaster 403 — sprites flèche de cap (style 07 isométrique 3D).
 * FICHIER GÉNÉRÉ par ui/assets/gen_cap_arrow.py — ne pas éditer à la main.
 * Licence : GPL-3.0.
 */

#include "img_cap_arrow.h"

static const uint8_t img_cap_arrow_map[] = {
    0x4D, 0xB8, 0xFF, 0x00, 0x4D, 0xB8, 0xFF, 0x00, 0x4D, 0xB8, 0xFF, 0x00, 0x4D, 0xB8, 0xFF, 0x00,
    0x4D, 0xB8, 0xFF, 0x00, 0x4D, 0xB8, 0xFF, 0x00, 0x4D, 0xB8, 0xFF, 0x00, 0x4D, 0xB8, 0xFF, 0x00,
    0x4D, 0xB8, 0xFF, 0x00, 0x4D, 0xB8, 0xFF, 0x00, 0x4D, 0xB8, 0xFF, 0x00, 0x4D, 0xB8, 0xFF, 0x00,
    0x4D, 0xB8, 0xFF, 0x00, 0x4D, 0xB8, 0xFF, 0x00, 0x4D, 0xB8, 0xFF, 0x00, 0x4D, 0xB8, 0xFF, 0x00,
    0x4D, 0xB8, 0xFF, 0x00, 0x4D, 0xB8, 0xFF, 0x00, 0x4D, 0xB8, 0xFF, 0x00, 0x4D, 0xB8, 0xFF, 0x00,
    0x4D, 0xB8, 0xFF, 0x00, 0x4D, 0xB8, 0xFF, 0x00, 0x4D, 0xB8, 0xFF, 0x00, 0x4D, 0xB8, 0xFF, 0x00,
    0x4D, 0xB8, 0xFF, 0x00, 0x4D, 0xB8, 0xFF, 0x00, 0x4D, 0xB8, 0xFF, 0x00, 0x4D, 0xB8, 0xFF, 0x00,
    0x4D, 0xB8, 0xFF, 0x00, 0x4D, 0xB8, 0xFF, 0x00, 0x4D, 0xB8, 0xFF, 0x00, 0x4D, 0xB8, 0xFF, 0x00,
    0x4D, 0xB8, 0xFF, 0x00, 0x4D, 0xB8, 0xFF, 0x00, 0x4D, 0xB8, 0xFF, 0x00, 0x4D, 0xB8, 0xFF, 0x00,
    0x4D, 0xB8, 0xFF, 0x00, 0x4D, 0xB8, 0xFF, 0x00, 0x4D, 0xB8, 0xFF, 0x00, 0x4D, 0xB8, 0xFF, 0x00,
    0x4D, 0xB8, 0xFF, 0x00, 0x4D, 0xB8, 0xFF, 0x00, 0x4D, 0xB8, 0xFF, 0x00, 0x4D, 0xB8, 0xFF, 0x00,
    0x4D, 0xB8, 0xFF, 0x00, 0x4D, 0xB8, 0xFF, 0x00, 0x4D, 0xB8, 0xFF, 0x00, 0x4D, 0xB8, 0xFF, 0x00,
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
    .header = {
        .magic  = LV_IMAGE_HEADER_MAGIC,
        .cf     = LV_COLOR_FORMAT_ARGB8888,
        .w      = 64,
        .h      = 64,
        .stride = 256,
    },
    .data_size = sizeof(img_cap_arrow_shadow_map),
    .data      = img_cap_arrow_shadow_map,
};
