docteurzoidberg/raidmaster-403/(commit log)

2026-10-09 Initial: cahier des charges + étape 1 (squelette CMake + sim SDL)
    Cahier des charges complet (CLAUDE.md, PROMPT.md, AGENTS.md,
    prompts/features|hardware|boitier|firmware|ui|simulation.md) préparé
    pour un travail multi-agents.
    Étape 1 du plan d'implémentation réalisée : squelette CMake avec
    presets sim/firmware, structure dossiers, licence GPL-3.0, et cible
    sim qui ouvre une fenêtre SDL 480×320 landscape blanche. Build vert
    sous -Wall -Wextra -Wpedantic sur SDL2 2.30 / CMake 3.28 / GCC 13.
2026-10-09 Renommage: tripmaster-gps → raidmaster-403
    Aligne le nom du projet local sur le dépôt GitHub (raidmaster-403) :
    - dossier local tripmaster-gps/ → raidmaster-403/
    - project CMake tripmaster_gps → raidmaster_403
    - variable TRIPMASTER_TARGET → RAIDMASTER_TARGET
    - exécutable sim tripmaster-sim → raidmaster-sim
    - document Fusion prévu tableau-tripmaster-gps → tableau-raidmaster-403
    - titres des briefs et contextes minimaux : "Raidmaster 403"
    Le mot "tripmaster" est conservé comme terme générique du métier
    (instrument d'odométrie rallye) dans les descriptions fonctionnelles.
    Références parent (../CLAUDE.md, ../PROMPT.md) mises à jour en même temps.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
2026-10-09 UI etape 1-6: fondations LVGL v9 + ecrans MVP + input + demo auto
    - Integration LVGL v9.2.2 via FetchContent, lv_conf.h local avec palette
    Montserrat 12..48, log via printf, memoire 256 KB.
    - Dérogation sim-/ documentée (commentaires UI-agent exception) :
    * CMakeLists.txt top-level : add_subdirectory(ui) avant sim.
    * sim/CMakeLists.txt : link raidmaster_ui + libm.
    * sim/main.c : init LVGL avec buffer software RGB565, flush via
    SDL_UpdateTexture + SDL_RenderCopy ; routage clavier a/b/+/-/m/n/v/d.
    - Tokens de design (ui/ui_tokens.h) : palette LCD jour + nuit + fonts
    Montserrat fallback (TODO Share Tech Mono + Inter en phase 2 via lv_font_conv).
    - Thème LVGL simple (ui/theme.{c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
2026-10-09 UI etape 7: documentation + fix cosmetique balade
    - prompts/ui.md § 8 : état d'implémentation détaillé (build, fichiers,
    raccourcis clavier, TODO cross-agent, décisions retenues).
    - PROMPT.md § 7 : entrée datée 2026-10-09 pour l'agent UI.
    - screen_balade.c : supprime un lv_obj_align() dupliqué sur s_lbl_speed.
    [screen_balade.c]
2026-10-09 tests/tools: scripts Python NMEA (staging v0 pour agent simulation)
    Prépare la boîte à outils du simulateur en pure stdlib Python 3.8+,
    en attendant que l'agent simulation entre en scène à l'étape 2 puis 4
    du plan.
    Scripts :
    - gen_nmea.py : génère NMEA synthétique (linear, stationary, circular)
    - add_noise.py : jitter gaussien + HDOP spikes + perte de fix
    - validate_nmea.py : checksums + continuité temporelle
    - compute_reference.py : distance Haversine « vérité terrain »
    - gpx_to_nmea.sh : wrapper gpsbabel (pas requis mais utile)
    - record_live.py : lit u-blox via pyserial (TODO : quand NEO-M9N arrivera)
    Vérifiés en bout en bout :
    - linear 90 km/h × 1 h : 89.997 km (écart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
    [add_noise.py, compute_reference.py, gen_nmea.py, record_live.py, validate_nmea.py]
2026-10-10 UI : écrans fidèles aux maquettes, polices compilées, flèche de cap 3D
    - Tout l'écran en Share Tech Mono, en polices bitmap LVGL compilées
    (ui/fonts/stm_<px>.c, générées par ui/fonts/gen_fonts.sh avec
    lv_font_conv 1.5.3), mêmes fichiers sim et ESP32, seules tailles et
    glyphes utilisés (~180 Ko flash).
    - Barre d'état commune et briques de mise en page (ui_widgets),
    textes calés sur la ligne de base, ODO avec espace des milliers.
    - Raid, balade, menu, calibration et boot refaits d'après la maquette ;
    silhouette 403 et points de progression au démarrage.
    - Flèche de cap 3D (style 07) dans la cellule CAP, ombre séparée.
    - Mode nuit complet : palettes jour/nuit, recons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
2026-10-10 Boot animé (403 HD sur grille glow), GIF de démo auto, copies des artefacts
    - Démarrage : la 403 HD tourne sur une grille cyan lisse avec glow fort
    (rendu Blender), « 403 » en haut, RAIDMASTER, points et version en bas.
    Fichier RMBA (palette 256 couleurs, ~5,5 Mo) généré au build depuis la
    planche par ui/assets/boot_anim/build_boot_anim.py ; ui/boot_anim.c le
    convertit en RGB565 dans un tampon unique. Écran boot libéré après la
    rotation ; repli sur le boot statique si l'animation manque.
    - Scène Blender ui/assets/boot_anim/boot_anim.blend : voitures PS1 et HD
    (use_car), grille FX_CyanFade, compositeur BootGlow.
    - GIF de démo de l'UI (sim/demo_record, sim/gif_writer,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
2026-10-10 README : présentation, GIF de démo, build, tests, guide pour partir de zéro
2026-10-10 Core : parseur NMEA sur minmea (issue #4), tests Unity, ctest
    - minmea copié dans core/third_party/minmea (MIT), timegm remplacé pour newlib
    - core/gps_parser : époques RMC + GGA → gps_fix_t, coordonnées en double
    - tests/test_gps_parser.c (Unity v2.6.1) : 22 tests, rejeu des traces si présentes
    - preset de test ctest sim ; Python pour l'animation détecté sans le dossier 403 parent
    - CLAUDE.md : règle de mise à jour du README ; décision notée dans PROMPT.md et firmware.md
    [gps_parser.c, gps_parser.h, test_gps_parser.c]
2026-10-10 Outils : tools/check.sh et skills sim-check / ship, captures du sim corrigées
    - tools/check.sh : build, avertissements, tests ctest/Unity et état du GIF en 3 lignes
    - skills Claude Code du projet : sim-check (vérification) et ship (commit, fusion, push)
    - skills locaux ui-shots, boot-anim, ui-font exclus de git
    - sim : le scénario de captures attend la vraie durée du boot animé (3 s) ; avant, la démo
    écrasait l'état de la maquette et 5-calib montrait l'écran raid
    - README et CLAUDE.md : mention de check.sh et des skills
    [main.c]
2026-10-10 Core : moteur de trip, câblage UI et rejeu GPS dans le sim (étapes 2, 3 et 4 phase 1)
    - core/trip_engine : distance par intégration de la vitesse Doppler, trips A/B, odo, moyenne, max,
    chrono, calibration manuelle et automatique ; tests sur les traces de référence.
    - core/app : boutons, menu, réglages (fuseau, nuit, écran principal, alarme vitesse par pas de
    10 km/h, log GPX), sauvegarde via hal_storage ; interfaces HAL storage / gps / time.
    - hal_sim : stockage JSON, rejeu .nmea (×1 à ×100, boucle) ou trajet simulé, coupure du signal,
    horloge virtuelle.
    - UI : ui_app relie le core aux écrans, menu et calibration actifs, alarme vitesse en rouge, cap
    inconnu, animation de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
2026-10-10 Sim : catalogue de 21 scénarios de bout en bout, traces générées depuis un itinéraire texte
    - tests/tools/gen_route.py : route.txt (segments, bruit, pertes de fix, HDOP, fix 2D) → NMEA
    RMC + GGA + GSA et distance vérité par repère ; traces générées au build, non versionnées.
    - Scénarios des phases 1 à 5 et partie GPS des phases 6-7 (prompts/simulation.md § 3) ;
    s01/s03 renumérotés s24/s25, s02_arret_bruit remplacé par s10_stationary_noise.
    - Sim : --speed jusqu'à ×1000, instants « @<s> » de trace, champs expect avg, max, hhmm,
    alarm, chrono, gps_err, commande power_cut.
    - Docs : README, PROMPT.md (état, journal, décision ouverte sur la fréquence de sauvegarde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
    [gen_route.py, main.c]
2026-10-10 Structure : code dans software/, maquettes dans docs/mockups/
    - core, ui, sim, hal_*, firmware, tests, tools et CMake déplacés dans software/ ; RAIDMASTER_REPO_DIR
    pour la doc à la racine (GIF de démo, planche de l'animation de démarrage).
    - docs/artefacts/ renommé docs/mockups/, docs/user/ (notice à venir).
    - .gitignore et skills sim-check / ship adaptés.
2026-10-10 Matériel : carte ESP32-S3-Touch-LCD-3.5B, datasheets et modèle 3D
    - Carte commandée : 3.5B (écran et tactile AXS15231B en QSPI, expandeur TCA9554) ; briefs hardware,
    firmware, ui, features et simulation mis à jour.
    - hardware/ : index des datasheets et fetch_datasheets.sh (PDF hors git).
    - enclosure/ : modèle 3D et plan coté Waveshare (hors git), cotes reprises dans prompts/boitier.md § 3.1.
2026-10-10 Doc : README, CLAUDE, AGENTS et PROMPT pour la nouvelle organisation
    Commandes depuis software/, arborescence, règle de racine propre, matrice qui-touche-quoi
    (enclosure/, docs/), journal : carte 3.5B et réorganisation.
2026-10-10 Doc : carte fille 4 couches, intégration GPS et magnétomètre, PROMPT.md à jour
    - prompts/hardware.md : carte fille 4 couches sous KiCad (§ 9 : format sandwich, piste RF 50 Ω,
    brouillage QSPI, plots de test, fabrication, ordre de validation), GPS (§ 2 : antenne à demeure +
    prise SMA, alimentation, V_BCKP, configuration UBX, M10 à évaluer), magnétomètre en carte module
    optionnelle et risque de saturation par les aimants (§ 3), BOM, décisions ouvertes.
    - prompts/boitier.md : prise SMA de cloison, carte fille, éloignement magnétomètre / aimants.
    - PROMPT.md : contexte, phase actuelle, étapes 7 à 14, état de session, journal annoté ; issue #3
    fermée. README : ligne d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
2026-10-24 Matériel : projet KiCad de la carte fille et de la carte boutons
    - hardware/kicad/carte-fille/ : schémas carte fille (NEO-M9N, bias-T d'antenne, AP2112K, XC6206 pour
    V_BCKP, GY-271) et carte boutons (MCP23017, LED bicolores), PCB 4 couches avec la carte boutons
    détachable, nappe FFC 6 voies, modèles 3D propres au projet (3d/, origine dans son README)
    - skill pcb-carte-fille : repères du PCB, contrôles, export STEP pour Fusion, maquette HTML
    - maquettes boitier-concept, boitier-maison et carte-fille-concept recalées sur la carte réelle
    - prompts/hardware.md § 9 (brochage, composants, carte boutons) et TODO boîtier dans prompts/boitier.md
    - PROMPT.md : journal du 2026-10-11 ; .gi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
    [GY-271_module.step, carte-boutons.kicad_sch, carte-fille.kicad_pcb, carte-fille.kicad_sch, ublox_NEO.step]
2026-10-24 Firmware : premier firmware de démo sur la Waveshare ESP32-S3-Touch-LCD-3.5B
    - software/firmware/ : projet ESP-IDF v5.5.6 (main.c, sdkconfig.defaults, partitions avec
    l'animation de démarrage en flash, menu « Raidmaster 403 »), mêmes core/ et ui/ que le sim
    - hal_esp32/ : écran AXS15231B en QSPI (rotation logicielle, bandes DMA), tactile en guise des
    5 boutons, NVS, RTC PCF85063, PMIC AXP2101 (état USB / batterie / charge, bouton PWR et
    extinction, charge de la pile RTC coupée), GPS de démo
    - core : trajet simulé partagé (gps_synth), interfaces hal_asset et hal_power, horloge UTC réglée
    au premier fix GPS de chaque démarrage
    - ui : état d'alimentation dans la barre d'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
    [partitions.csv]
2026-10-24 Core : jingle de démarrage « Grille néon » (sim et firmware)
    - core/synth : petit synthétiseur, table de notes → PCM 16 bits mono 22 050 Hz rendu par blocs
    (impulsion, dents de scie, sinus, bruit, enveloppe, désaccord, écho), sans allocation.
    - core/jingles : partition JINGLE_BOOT (arpèges la m · fa · sol, accord de La majeur, 2,86 s) et
    jingle_play() ; nouvelle interface hal_audio (rappel tiré par le fil audio).
    - Sim : sortie SDL (hal_sim/hal_audio_sdl.c), jingle avec l'animation en mode interactif seulement ;
    détection de SDL2 remontée au CMakeLists racine.
    - Firmware : hal_esp32/hal_audio_es8311.c (esp_codec_dev 1.3.4, tâche audio sur le cœur 1), ampli
    NS4150B al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
2026-10-25 Firmware : écran allumé sans bruit au démarrage
    - Mémoire du panneau mise au noir avant DISPON (clear_panel, ~16 ms) : elle contenait du bruit
    après le reset.
    - Rétroéclairage tenu à 0 % dès le début de board_init (base du transistor sans résistance de
    rappel).
    - Rétroéclairage allumé 50 ms après la fin réelle de l'envoi de la première image
    (board_display_wait_idle) : le panneau relit sa mémoire à ~60 Hz et les cristaux suivent en
    quelques dizaines de ms ; avant, on voyait brièvement l'ancien contenu.
    - Doc : brief firmware (rétroéclairage), journal PROMPT.md du 2026-10-25.
    [board.c, board.h, board_display.c, main.c]
2026-10-25 UI : animation de démarrage calée sur le jingle (un tour, longue glissade)
    - Un seul tour au lieu d'une rotation constante en boucle : la 403 s'élance sur les arpèges
    (vitesse maxi à 0,68 s), ralentit en roue libre jusqu'au silence (~2,7 s) et s'arrête dans sa
    pose de départ. 36 images à 12 i/s inchangées ; RMBA v2 : 0,95 Mo (1,1 Mo avant).
    - Scène Blender : cinq profils en actions sur le Pivot (Synchro_A à E), C retenue ; planche
    docs/mockups/boot-anim/6_synchro_glissade.png, chemin dans cmake/boot_anim.cmake.
    - Page de comparaison des cinq profils avec le jingle : docs/mockups/boot-synchro.html (images
    en 256 couleurs) ; section « 06 » ajoutée à boot-anim.html ; GIF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
2026-10-25 Doc : boîtier de référence MakerWorld (source OpenSCAD et cotes éprouvées)
    - enclosure/reference/makerworld-2552125/ : source OpenSCAD (BOSL2) de la coque
    « Waveshare ESP32-S3 3.5" Case (Parametric) », testée par son auteur sur la même carte ;
    licence MakerWorld sans redistribution, à retirer avant de rendre le dépôt public
    - prompts/boitier.md § 3.2 : cotes éprouvées (vitre, colonnes, USB-C, SD, boutons,
    poussoirs) et écarts à recouper avec nos relevés du 2026-10-11
    - enclosure/README.md, README.md (arborescence, composants tiers), CLAUDE.md, journal PROMPT.md
2026-10-25 Doc : fichiers de référence du boîtier et rendu OpenSCAD vérifié
    - prompts/boitier.md : tableau « Fichiers de référence » (STEP, plan, SCAD, 3MF : contenu,
    versionné ou non, section des cotes), installation de BOSL2 et lenteur du rendu en 2021.01
    - rendu du SCAD vérifié : même coque que le 3MF publié (97,24 × 65,80 × 21,30)
    - prompts/hardware.md : renvoi vers enclosure/reference/
    - enclosure/README.md : BOSL2 installé sous WSL et Windows, avertissements sans effet du fichier
    - PROMPT.md : § 6 bis au 2026-10-25 (boîtier de référence, cotes à recouper), journal complété
2026-11-11 Matériel : connecteurs de nappe J4 / J101 face à face sur le PCB
    - J4 (carte fille) en (164 ; 88,2) et J101 (carte boutons) en (108 ; 116,5), tous deux en B.Cu :
    les cartes étant montées tête-bêche, ils tombent face à face dans le boîtier (x_J4 + x_J101 = 272).
    - R2 et R6 à R8 restent où le propriétaire les a déplacés.
    - Placement seulement, rien n'est routé ; DRC inchangé.
    [carte-fille.kicad_pcb]
2026-11-11 Doc : maquette 3D des cartes dans leur boîtier (scène Blender, page, skill)
    - docs/mockups/maquette-3d/ : scène Blender construite par script (outils/scene.py, réglages dans
    maquette.json) depuis les STEP de KiCad et le modèle Waveshare, modèle raidmaster.glb, page
    three.js assemblé / éclaté avec la démonstration animée (trappe micro-SD, carte, câble USB-C).
    - Boîtier de principe validé par le propriétaire le 2026-11-11 : 123 × 95,6 × 32,2 mm, formes à
    facettes, flancs taillés pour la prise USB-C, manchon USB-C rapporté, trappe micro-SD coulissante
    à clip, sans aimants noyés. Essais, cotes, contrôles et décisions ouvertes dans ESSAIS.md.
    - Outils de publicatio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
2026-11-11 Doc : images rendues de l'animation de démarrage hors git
    - docs/mockups/boot-anim/ et boot-synchro/ sortis de l'index (gardés en local, .gitignore) ; les
    scènes Blender ui/assets/boot_anim/*.blend restent versionnées.
    - Sans la planche, le sim et la carte démarrent sur l'écran de boot statique.
2026-11-11 Skills : boot-anim, ui-shots et ui-font versionnés ; pcb-carte-fille sans chemin personnel
    - boot-anim, ui-shots, ui-font : retirés du .gitignore, versionnés dans le dépôt privé ; boot-anim écrit
    ses planches dans docs/mockups/boot-anim/ (hors git).
    - pcb-carte-fille : export_step.sh et maquette.py trouvent le dépôt et le Temp Windows eux-mêmes ;
    SKILL.md sans chemin ni nom personnel.
2026-11-11 Maquette : page web 3D déplacée dans mockup/ pour GitHub Pages
    - index.html, main.js, style.css et raidmaster.glb passent de docs/mockups/maquette-3d/ à mockup/
    (racine), avec un README.md public ; .nojekyll pour que GitHub Pages serve la page telle quelle.
    - La scène Blender, les outils, maquette.json et ESSAIS.md restent dans docs/mockups/maquette-3d/ :
    scene.py exporte vers mockup/raidmaster.glb, page_autonome.py lit la page dans mockup/.
    - Skill maquette-3d, AGENTS.md et READMEs des maquettes à jour.
2026-11-11 Boîtier : README public des modèles 3D externes, dossier stepfiles/
    - enclosure/README.md (public) : modèles 3D externes utilisés (Waveshare, boîtier d'origine 3.5B-C,
    MakerWorld, u-blox NEO, bouton Würth) avec adresse et description, liste des fichiers STEP du projet.
    - enclosure/stepfiles/ : futurs exports STEP du boîtier depuis Fusion (README.md).
    - Boîtier de référence MakerWorld et notes OpenSCAD dans enclosure/reference/README.md (privé) ;
    renvois de prompts/boitier.md et prompts/hardware.md corrigés.
2026-11-11 README : version écrite pour le dépôt public
    - Plus aucun renvoi vers les briefs, PROMPT.md, CLAUDE.md, docs/mockups ou hardware/.
    - Sections « Maquette 3D » (GitHub Pages) et « Documentation » ; arborescence limitée aux dossiers
    publiés ; three.js dans les composants tiers ; boîtier MakerWorld retiré (voir enclosure/README.md).
    - Animation de démarrage : rendue dans Blender, scène et images rendues non publiées.
2026-11-11 Doc : dépôt privé de travail et dépôt public par liste blanche
    - Dépôt de travail renommé raidmaster-403-private (privé, garde tout) ; dépôt public raidmaster-403,
    copie filtrée de main par liste blanche (README.md, LICENSE, .gitignore, .nojekyll, software/ sans
    les .blend, enclosure/README.md, enclosure/stepfiles/, mockup/, GIF de démo).
    - CLAUDE.md : organisation (mockup/, enclosure/stepfiles/, .nojekyll, CLAUDE.local.md), règle de
    publication, liste des skills.
    - CLAUDE.local.md (privé, non publié) : renvois vers les fichiers privés, dépôts, projet Fusion.
    - PROMPT.md § 7 : décision du 2026-11-11, TODO des renvois privés dans software/.
    - Skill ship : deux dép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
2026-11-11 Doc : commentaires de software/ sans renvoi vers les fichiers privés
    - Renvois vers les briefs (prompts/), PROMPT.md, les maquettes et hardware/ retirés ou reformulés
    dans les commentaires (écrans, thème, tokens, sim, HAL ESP32, partitions, tests) ; schéma de la
    carte cité par son adresse Waveshare.
    - Format de route.txt et actions.txt décrit dans tests/fixtures/scenarios/README.md.
    - Jargon multi-agents retiré (« UI-agent exception », « cross-agent », « agent simulation »).
    - Polices stm_* regénérées par gen_fonts.sh : en-têtes en chemins relatifs, glyphes inchangés.
    - Seul renvoi gardé : la planche lue au build par cmake/boot_anim.cmake.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
    [partitions.csv]
2026-11-11 Maquette : publiée à la racine de GitHub Pages par un workflow
    - .github/workflows/pages.yml : publie mockup/ à la racine du site (GitHub Actions), seulement sur le
    dépôt public ; mockup/ ne bouge pas dans le dépôt.
    - .nojekyll supprimé (inutile en mode workflow).
    - Adresse de la maquette : https://docteurzoidberg.github.io/raidmaster-403/ (README, mockup/,
    enclosure/, maquette-3d, CLAUDE.md, CLAUDE.local.md, PROMPT.md, skill ship).
2026-11-11 Maquette : page en français et en anglais, lien vers le dépôt GitHub
    - Header : sélecteur de langue (drapeau SVG + menu) et lien GitHub avec son icône.
    - Textes de la page traduits dans main.js ; textes du modèle (groupes, visserie, note, étapes de la
    démonstration) traduits par MODELE_EN, le français du modèle servant de repli.
    - Langue : ?lang=fr|en, sinon dernier choix (localStorage), sinon langue du navigateur.
    - Vérifié dans Chrome : bascule FR / EN, fiches des pièces, affichage à 400 px, console vide.
2026-11-11 Matériel : report dans KiCad des essais validés de la maquette
    - Carte boutons retournée dans le sens du montage (boutons et LED en B.Cu,
    CMS et J101 en F.Cu), boutons au pas de 18,5 mm, J4 et J101 au même x
    - 2 × PCF8574T (SOIC-16 large) à la place du MCP23017, qui ne tenait plus
    entre deux boutons à ce pas
    - Boussole GY-271 soudée à plat côté GPS, à l'opposé de la prise USB-C
    - Plots de réserve pour un bouton PWR déporté (J8 broche 23)
    - Coins bas de la carte boutons coupés à 45° (empreinte de contour CT1,
    bibliothèque du projet raidmaster.pretty)
    - U2 retourné, L1 et D1 collés à la ligne radio ; réserves en bord de
    carte fille pour de futurs ports d'extensi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
    [GY-271_module.step, carte-boutons.kicad_sch, carte-fille.kicad_pcb, carte-fille.kicad_sch]
2026-11-11 Maquette : régénérée depuis le PCB, nappe FFC, boîtier de 93,6 mm
    - Cartes réimportées de KiCad (plus d'essai sur les cartes), carte boutons
    placée comme la carte fille
    - Nappe FFC entre J4 et J101 (pièce nappe) et contrôle controle_nappe()
    - Essai 15 : bas du boîtier remonté de 2 mm, vis M3 du bas devant les
    coins coupés de la carte boutons
    - Page : textes à jour (français et anglais), erreur de la page en un seul
    fichier corrigée (balise description absente)
    - ESSAIS.md, README et skill maquette-3d mis à jour
2026-11-11 README : rendus des cartes et du boîtier
    - docs/demo : cartes vues de dessus et de dessous (visualiseur 3D de
    KiCad), boîtier assemblé et éclaté (Blender)
    - Section « Cartes électroniques », images dans « Maquette 3D »
    - Les quatre images rejoignent la liste blanche du dépôt public
    - PROMPT.md : point de la session et journal des décisions
2026-11-12 Matériel : carte boutons tenue par 4 vis (trous H7 / H8)
    - Deux trous M2 de plus en bas de la carte boutons, H7 (89 ; 121,3) et H8 (183 ; 121,3) ;
    R104 et R106 déplacées à côté de R103 et R105 pour dégager les bossages
    - export_step.sh : H7 / H8 dans la liste de la carte boutons
    - hardware.md § 9.4 : 4 vis, bloc des cartes vissé par l'arrière, ordre des boutons vérifié à la netlist
    - Rendus des cartes du README refaits
    [carte-fille.kicad_pcb]
2026-11-12 Maquette : cloison, batterie sous trappe vissée, visserie CHC, légendes des boutons
    - Essai 16 : cloison de 1 mm d'une pièce avec la coque arrière, bloc Waveshare + carte fille vissé
    par 4 vis CHC M2 × 12 posées par l'arrière, batterie dans une poche fermée par une trappe vissée
    (4 vis CHC M3 × 5, inserts à chaud) ; boîtier de 123 × 93,6 × 33,2 mm
    - Essai 17 : 4 bossages et 4 vis CHC M2 × 6 pour la carte boutons
    - Essai 18 : légendes incrustées de 0,6 mm pour l'impression multi-filament (A ambre, B cyan,
    menu rouge, triangles blancs, éclair rouge sur PWR)
    - Vis CHC ISO 4762 et inserts M3 modélisés, visserie inox ; perçages d'inserts Ø 4,33 × 5 mm
    - Rendu des cir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
2026-11-12 Boîtier : modèle complet dans Fusion, STEP des 12 pièces
    - document Fusion raidmaster dessiné d'après la scène de référence (10 étapes), lèvre de centrage au joint
    - STEP des 12 pièces dans enclosure/stepfiles/, listes de enclosure/README.md à jour
    - prompts/boitier.md § 3.3 : cotes du modèle ; enclosure/PROMPT-fusion.md gardé jusqu'à validation
    [capuchon_A.step, capuchon_B.step, capuchon_bas.step, capuchon_haut.step, capuchon_menu.step, coque_arriere.step, facade.step, manchon_usb.step]
2026-11-12 Maquette : aspect retenu construit par scene.py, scène de référence raidmaster.blend
    - raidmaster.json (même nom que la scène) remplace maquette.json, ancienne scène et copie d'aspect dans archives/
    - scene.py construit cannelures, lèvre de centrage, pare-chocs TPU, liseré, lettrage et trappe micro-SD enfoncée ; tout() redonne la scène
    - mockup/raidmaster.glb et page régénérés, rendus du README refaits
    - docs, skill maquette-3d, PROMPT.md, CLAUDE.md, AGENTS.md à jour
2026-11-12 Matériel : schémas de la carte fille et de la carte boutons réenregistrés par KiCad
    - format réécrit à l'ouverture dans KiCad 10, repères utilisés notés dans le projet
    [carte-boutons.kicad_sch, carte-fille.kicad_sch]
2026-11-12 Boîtier : coins TPU accrochés par 3 nervures chacun
    - Fusion version 12 : 12 nervures de 2 × 0,8 mm sur la coque, dans la feuillure du TPU, le long de Y (bouts du L et pan coupé), rainures ouvertes à l'arrière dans les coins TPU, jeu 0,1 ; paramètres tpu_nervure_*
    - STEP de la coque et du TPU réexportés
    - maquette : aspect.tpu.accroche (feuillure, languette, nervures) construit par scene.py, solveur MANIFOLD pour le TPU ; scène, GLB et page régénérés
    - boitier.md § 3.3 et § 4, journal PROMPT.md, enclosure/README.md, README et skill de la maquette
    [coque_arriere.step, pare_chocs.step]
2026-11-12 Matériel : connectique GPS puck ou interne, carte fille v1.1 placée
    - Étude docs/etudes/gnss-externe.md : puck NEO-M8N + boussole externe ou NEO-M9N interne, choisis au soudage
    - Maquette (essai 20 validé) : ouverture du flanc gauche, manchons puck / antenne, choix de la version
    dans Blender et sur la page ; pièce puck_carte, fiche JST-PH 6 et ses fils
    - Fusion : ouverture et manchons dessinés, STEP manchon_puck / manchon_antenne
    - KiCad v1.1 (schéma et placement, non routé) : J6 JST-PH 6 traversante, SRV05-4, TCA4307 VSSOP-8,
    R15-R18, champ Variante ; U1 tourné de 180° (ligne RF 10,9 mm), J3 descendu, copie parasite de la
    carte boutons retirée ; cartouche rév. 1.1
    - Page :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
    [carte-boutons.kicad_sch, carte-fille.kicad_pcb, carte-fille.kicad_sch, coque_arriere.step, manchon_antenne.step, manchon_puck.step]
2026-11-12 Boîtier : manchon du puck qui épouse la prise JST-PH 6
    - Fusion : carte fille v1.1 dans le boîtier (models/carte_fille v2) ; manchon_puck v3 : tunnel large et évasé
    gardé, fond de 1,2 mm percé à la forme de J6 (+0,25) et col qui entoure l'avant de J6 sous la carte ;
    manchon antenne inchangé (paramètres découplés) ; STEP manchon_puck réexporté
    - Maquette : même forme (boitier.gps.fond, col), scène et GLB régénérés, textes de la page (fr, en)
    - Docs : boitier.md § 3.4, enclosure/README.md, ESSAIS.md, journal PROMPT.md
    [manchon_puck.step]
2026-11-12 README : rendus des cartes d'après le PCB v1.1
2026-11-12 Boîtier : SMA bloquée dans le manchon antenne, manchon bouchon
    - Fusion : manchon antenne à trou en D (méplat 5,84) et logement hexagonal de l'embase (8 sur plats) ;
    composant manchon_bouchon (masqué) ; STEP manchon_antenne et manchon_bouchon
    - Maquette et page : SMA bloquée ; troisième version GPS « Bouchon » (?gps=bouchon), une pièce peut
    appartenir à plusieurs versions (puck_carte : « puck bouchon »)
    - Docs : boitier.md § 3.4, enclosure/README.md, mockup/README.md, maquette, journal PROMPT.md
    [manchon_antenne.step, manchon_bouchon.step]
2026-11-12 Firmware : liaison avec le récepteur u-blox (M9N ou puck M8N)
    - core/ubx : trames UBX, découpage du flux NMEA / UBX, MON-VER, réglages M9 (VALSET) et M8 (CFG-*)
    - core/gps_link : débit trouvé, modèle reconnu, 10 Hz automobile, débit cible, perte et reprise
    - hal_esp32/hal_gps_uart.c : UART1 IO17 / IO18, GPS_EN IO45 ; source GPS au choix dans menuconfig
    (démo par défaut)
    - tests test_ubx et test_gps_link (récepteur émulé)
    - README, README du firmware, brief firmware § 8 ter, journal
2026-11-12 Firmware : boussole du puck sur l'I2C1
    - core/mag : QMC5883L, IST8310, HMC5883L, LIS3MDL reconnus seuls, lecture à 20 Hz, repère voiture,
    orientation réglable, calibration par extrêmes, cap à plat, perte et retour
    - hal_esp32/board_compass.c : I2C1 IO39 / IO40, cap dans le journal, calibration provisoire de banc ;
    menuconfig « Boussole du puck » (activée avec le récepteur réel)
    - test test_mag (puces émulées par leurs registres)
    - README, README du firmware, brief firmware § 8 quater, journal
2026-11-12 UI : cap boussole, GPS absent, calibration de la boussole ; sim du puck
    - Core : hal_gps_present(), interface hal/hal_mag.h ; app : source du cap (boussole sous 13 km/h,
    route GPS au-dessus de 17 km/h, repli de l'une sur l'autre), calibration de la boussole par un
    tour sur place, enregistrée (clé magcal) ; tests dans test_app
    - Firmware : hal_mag_i2c.c (ex-board_compass.c, calibration de banc retirée), hal_gps_present
    pour la démo et l'UART
    - UI : « GPS × » dans la barre d'état, étiquette MAG / GPS / MAG × / MAG ? dans les cellules CAP,
    écran de calibration de la boussole (anneau de 36 secteurs), valeur du menu
    - Sim : core/gps_link face à un M8N émulé (touche g), bouss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
2026-11-12 Sim web : cible WebAssembly, portage du core et de l'UI, test Node
    - sim/script.c : lecteur des actions.txt extrait de sim/main.c, sans changement
    de comportement (sorties des 23 scénarios identiques)
    - hal_simweb/ : stockage localStorage et son Web Audio ; GPS, boussole,
    horloge, alimentation et assets repris tels quels de hal_sim/
    - simweb/ : front-end (horloge virtuelle par pas de 10 ms, framebuffer RGBA,
    fonctions exportées), index des scénarios, test Node
    - cible RAIDMASTER_TARGET=web, preset web, tools/web.sh
    - AGENTS.md : nouveaux dossiers au périmètre de simulation
2026-11-12 Sim web : page mockup/sim/ (tripmaster 3D, carte, panneau), web dans check.sh
    - écran vivant sur le nœud ecran du modèle, 5 capuchons cliquables (appui long
    à 600 ms), clavier du sim PC, mode 2D (?vue=2d)
    - carte Leaflet / OSM : trace complète, parcours, position reçue, suivi
    - panneau : scénarios du dépôt, vitesse, actions et expect vert / rouge,
    import NMEA, essais (nuit, signal, puck, boussole, tour, alimentation),
    son coupé par défaut (bouton Son), remise à zéro, journal ; FR / EN
    - module construit (raidmaster-sim-0.1.0, 1,6 Mo) et scénarios (14,5 Mo)
    - check.sh : tools/web.sh test et état de mockup/sim/ ; lien « Essayer » dans
    la page maquette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
2026-11-12 Sim web : documentation, module sans chemin local, skills
    - cible web : -ffile-prefix-map (le module publié ne contient plus le chemin du
    poste qui l'a construit)
    - plan : état des étapes 0 à 5, écarts au plan, mesures, hors plan
    - README, mockup/README.md, prompts/simulation.md § 1.2, PROMPT.md (§ 6 bis,
    § 7), CLAUDE.md, CLAUDE.local.md (animation dans le .data, licence Hum3D)
    - skills sim-check (lignes WEB) et ship (mockup/sim/, publication)
    - page : plus de renvoi privé ni de jargon dans sim.js
2026-11-12 Core : moyenne juste après un redémarrage (sauvegarde version 2)
    La moyenne divisait le trip A relu de la sauvegarde par un temps en mouvement
    remis à zéro au démarrage (MOY 885 km/h vue dans le simulateur web, 59 km
    au trip A après 4 min de route). trip_persist_t garde désormais le temps
    en mouvement, le max et la base de la moyenne depuis la RAZ Trip A.
    Une sauvegarde version 1 (carte, sim, navigateur) est relue sans perte de
    trips ni de réglages ; sa moyenne compte ce qui est roulé ensuite. 4 tests
    Unity de plus ; module web et mockup/sim/ reconstruits.
2026-11-12 Sim web : vue de face, écran seul, Recentrer, Centrer sur la carte
    - vue 3D de face par défaut, boîtier entier dans le cadre ; bouton « Recentrer »
    - bouton « Écran seul / Vue 3D » : sortie vidéo sur toute la largeur du cadre,
    barre des cinq boutons dessous ; choix gardé dans le navigateur
    - carte : « Suivre » devient l'interrupteur « Centrer » (véhicule gardé au
    centre, zoom autour de lui, coupé par un glisser)
    - module web : chemin de LVGL noté lvgl/ quel que soit son dossier
2026-11-12 Doc : simulateur web fusionné et publié, vues de la page
    - plan (en-tête, § 5, écarts), PROMPT.md § 6 bis, brief simulation § 1.2
    - mockup/README.md : vue de face, Recentrer, Écran seul, Centrer
2026-11-12 Matériel : STEP des cartes exportés de KiCad versionnés
    - hardware/kicad/carte-fille/export/ retiré du .gitignore : carte-fille.step
    et carte-boutons.step (export du 2026-11-12, regen-step-kicad)
    - export périmé carte-fille-panneau.step supprimé (il n'était pas suivi)
    [carte-boutons.step, carte-fille.step]
2026-11-12 Matériel : projet KiCad de la carte fille dans la liste blanche publique
    - hardware/kicad/carte-fille/ publié, sans 3d/ ni les sauvegardes
    (listes locales de docs/publication/) ; README : arborescence
    - 3d/gen3d.py (chemin personnel) déplacé dans le skill pcb-carte-fille
    - ship : liste blanche et contrôle des fichiers publics étendus
2026-11-12 Matériel : modèles 3D propres de la carte fille publiés aussi
    - hardware/kicad/carte-fille/3d/ dans la liste blanche (u-blox NEO, GY-271) ;
    anciennes versions de gen3d.py toujours exclues
2026-11-12 README : boutons ▲ / ▼ (haut / +, bas / −), comme les légendes du boîtier
2026-11-12 Web : site web/ (accueil, en-tête commun, maquette, simulateur, manuel)
    - mockup/ déplacé dans web/ : web/mockup/ (maquette 3D), web/sim/ (simulateur),
    web/README.md (tout le site) ; pas de redirection des anciennes adresses
    - accueil « écran vivant » : grille néon (horizon qui remonte au défilement),
    écran qui joue la démo, capuchons aux légendes du boîtier, défilement section
    par section, projet DIY non commercial, mention d'auteur
    - web/common/ : en-tête commun aux quatre pages (navigation, langue à drapeau,
    GitHub) ; anglais par défaut, français si le navigateur le préfère, choix
    gardé quand le visiteur change de langue
    - web/manual/ : page d'attente ; web/i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
2026-11-12 README : la voiture est une 403 break Familiale de 1961, pas de 1956
    Même correction sur l'accueil du site (FR / EN) et dans les briefs features et hardware.
2026-11-13 Web : code de la maquette et du simulateur en anglais
    - main.js, sim.js : identifiants, clés de texte (TEXTS, MODEL_EN) en anglais,
    commentaires en français
    - pages et CSS : ids, classes et attributs data-* en anglais
    - accès d'essai window.raidmasterSim : button, caps, pick ; état aux noms du C
    - gardés en français : paramètres d'URL publiés, clés du stockage du
    navigateur, données du modèle 3D (userData de scene.py)
    - test Node, chargeur de l'artefact (page_autonome.py), skills et docs suivent
2026-11-13 Boîtier : batterie 103665 couchée, trappe monobloc cannelée
    - Fusion : batterie 65 × 36 × 10 couchée, poche de 78 × 40, trappe monobloc à bosse de 4 mm
    et 7 cannelures, 4 vis M2 × 6 dans des inserts M2 au milieu de la feuillure, 2 inserts M3
    du support au dos, inserts M2 sous la carte boutons ; STEP de la coque arrière, de la façade
    et de la trappe de la batterie.
    - Étude docs/etudes/batterie-103665.md, prompts/boitier.md § 3.3, journal et état de PROMPT.md.
    - Maquette : essai 21 (raidmaster.json, scene.py, raidmaster.blend), web/mockup/raidmaster.glb
    et textes anglais ; recouvrement des coins TPU antérieur noté dans ESSAIS.md.
    - Rendus du boîtier du README (et web/i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
    [coque_arriere.step, facade.step, trappe_batterie.step]
2026-11-13 Boîtier : capuchons à 2 mm, guides anti-rotation, coins TPU à 2,5 devant
    - Fusion (raidmaster - v1) : capuchon_saillie 1,5 → 2 et deux guides anti-rotation opposés par
    capuchon (nervures au dos de la façade, encoches de la collerette, esquisses cotées par les
    paramètres guide_*), d'après l'éprouvette ep01 validée ; tpu_devant 1,2 → 2,5 pour que les coins
    dépassent les capuchons. STEP de la façade, des 5 capuchons et du pare-chocs refaits.
    - Éprouvettes : trappe micro-SD (ep04) validée ; 3MF d'impression dans enclosure/3mf/ (ep01 bouton,
    ep02 PWR à deux guides opposés, ep04 trappe), une pièce par filament pour les légendes.
    - Maquette : réglage boitier.capuchon_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
    [capuchon_A.step, capuchon_B.step, capuchon_bas.step, capuchon_haut.step, capuchon_menu.step, facade.step, pare_chocs.step]
2026-11-14 Boîtier : paroi 3,2, réparation du PWR, fichiers d'impression
    - Paroi de la coque portée à 3,2 (journal PROMPT.md § 7, 2026-11-13) ; rendus du
    boîtier du README et de l'accueil refaits.
    - Microswitch PWR cassé au montage : poussoir corrigé dans Fusion (pwr_x 25,0, nez
    chanfreiné), STEP du poussoir refait ; principe du PWR déporté et fiche
    docs/reparation.md ; réserve TP5 / TP6 notée dans prompts/hardware.md.
    - 3MF d'impression de la coque, de la façade, des manchons, des boutons, des
    trappes et des coins TPU ; éprouvettes rangées dans enclosure/3mf/epreuves/.
    [poussoir_pwr.step]
2026-11-14 Boîtier : manchons tenus en glissière, jeux de 0,10 pris sur les manchons
    - Fusion v41 : paroi de la coque épaissie autour de l'ouverture GPS avec une
    arête en V, creux en V dans les trois manchons GPS (aile supprimée), renfort
    du manchon du puck ; flanc gauche sans pan aux raccords de la taille (coque
    et façade) ; jeux des manchons GPS et USB-C à 0,10, pris sur les manchons.
    - STEP de la coque, de la façade et des quatre manchons refaits.
    - Éprouvettes ep06_manchon_gps et ep07_manchon_usb : 3MF (21 min, 3,5 g chacune).
    - Maquette 3D (essai 22) : scene.py et raidmaster.json, scène et GLB refaits,
    coupes superposées à Fusion ; sommets doubles de la façade fusionnés (faus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
    [coque_arriere.step, facade.step, manchon_antenne.step, manchon_bouchon.step, manchon_puck.step, manchon_usb.step]
2026-11-14 Matériel : BOM des deux cartes, publiée, et skill regen-bom
    - hardware/kicad/BOM.md : carte fille et carte boutons lues dans les schémas KiCad, une section
    GPS intégré (Variante commun + interne) et une section puck GPS externe minimale (commun + puck),
    non montés et pastilles à part, bloc « Hors schéma » tenu à la main
    - skill regen-bom (bom.py, --check) ; ajouté aux tables de ship et aux contrôles de pcb-carte-fille
    - BOM ajoutée à la liste blanche du dépôt public (CLAUDE.md, CLAUDE.local.md, ship, README)
